lassezuengel/OpenMicroQuad-S1/assets/stackup.png

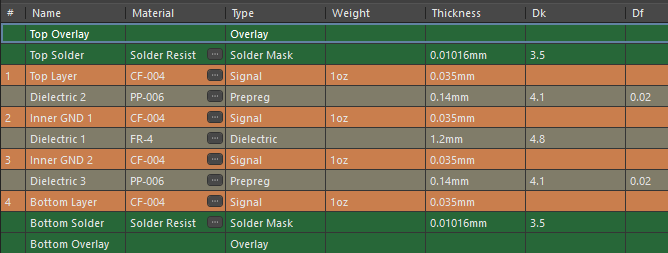
assets/stackup.png
