lassezuengel/OpenMicroQuad-S1/mcad/Drone 1S.step

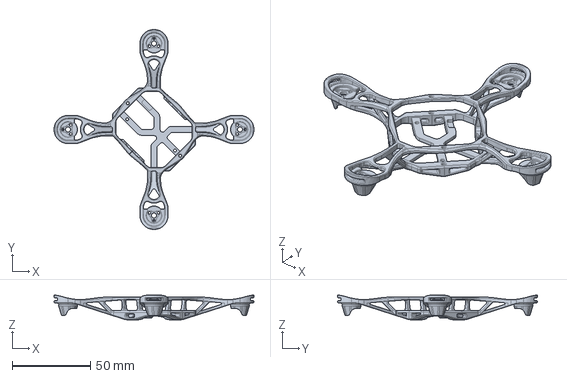
[picture p10: CAD file, 2026-10-10]
mcad/Drone 1S.step
128.0 x 128.0 x 15.8 mm
