lassezuengel/OpenMicroQuad-S1/ecad/ESC-FPV/ESC-FPV/ESC-FPV.pdf

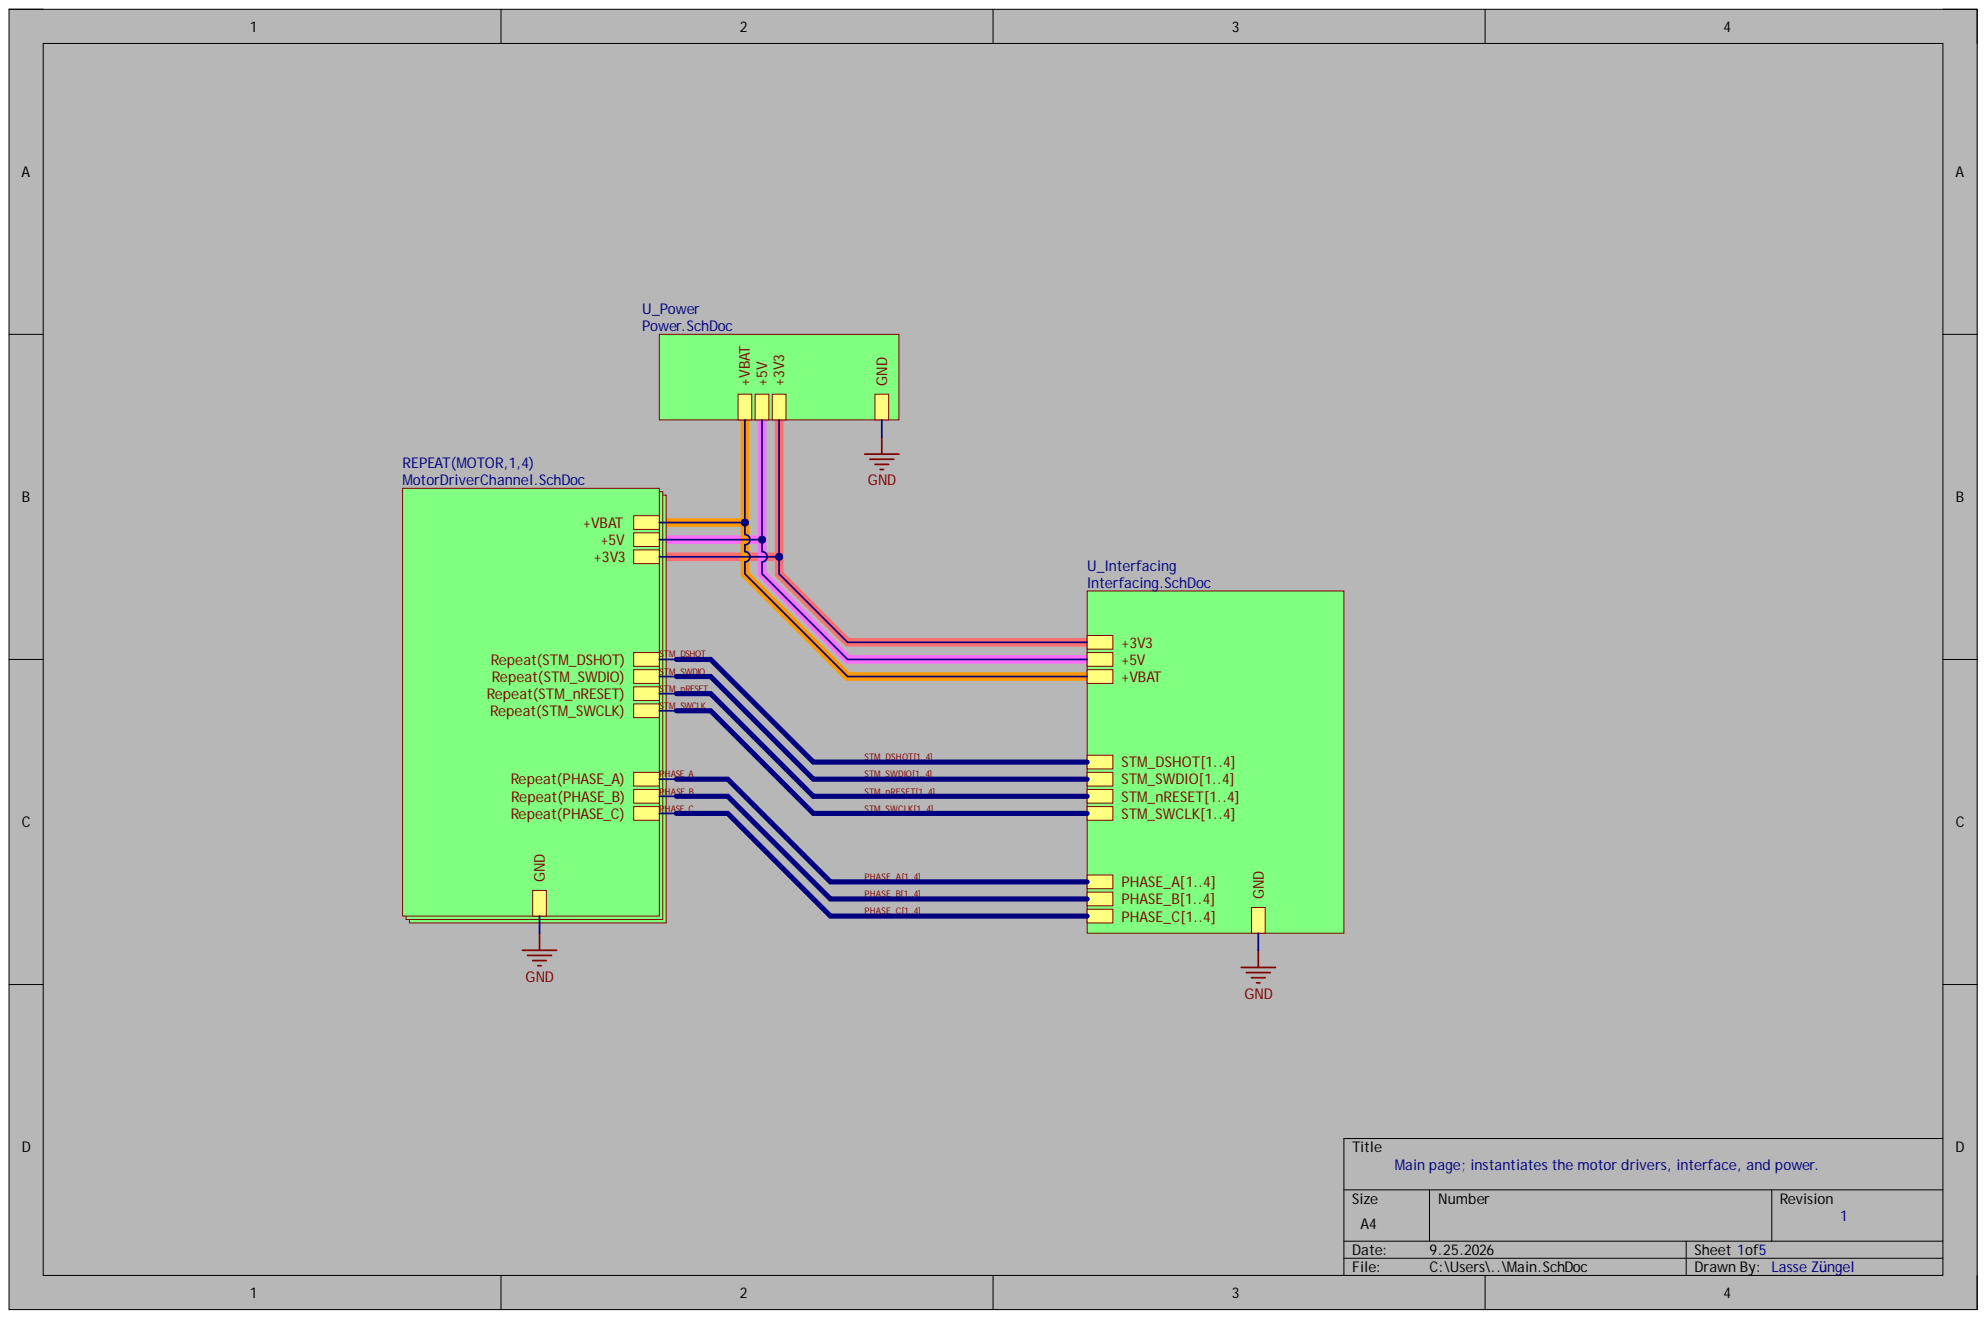
[picture p11: page 1]

Title
Main page; instantiates the motor drivers, interface, and power.

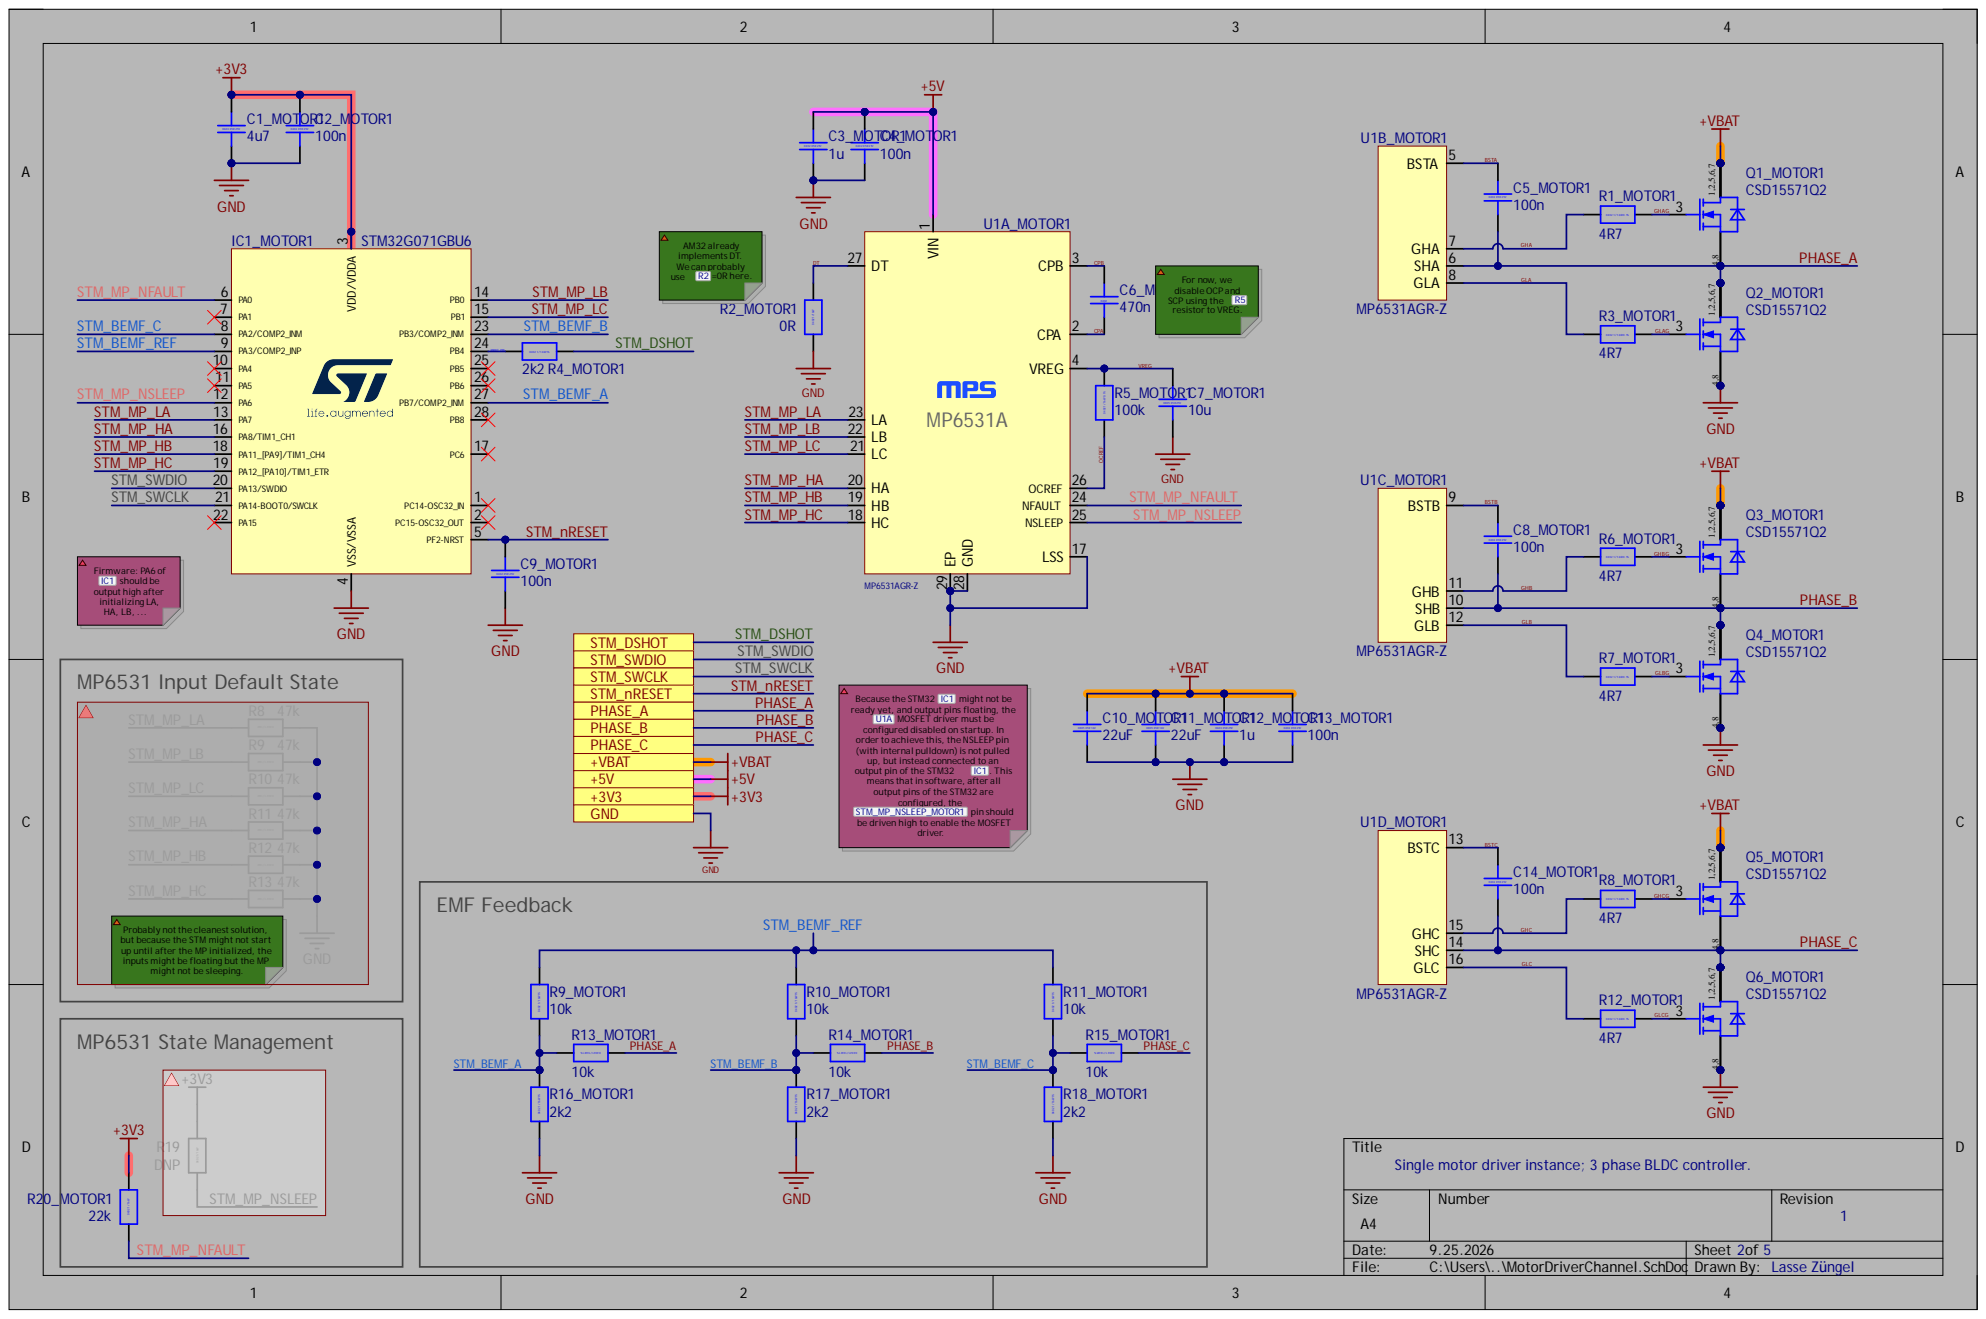
[picture p12: page 2]

VDD/VDDA 3 VSS/VSSA 4

Because the STM32 IC1 might not be
ready yet, and output pins floating, the

U1A MOSFET driver must be
configured disabled on startup. In
order to achieve this, the NSLEEP pin
(with internal pulldown) is not pulled
up, but instead connected to an
means thatin software, after all
output pins of the STM32 are
configured, the

STM_MP_NSLEEP_MOTOR1 pin should
be driven high to enable the MOSFET

Probably notthe cleanest solution,
but because the STM might not start
up until after the MP initialized, the
inputs might be floating but the MP

might not be sleeping.

Title
Single motor driver instance; 3 phase BLDC controller.

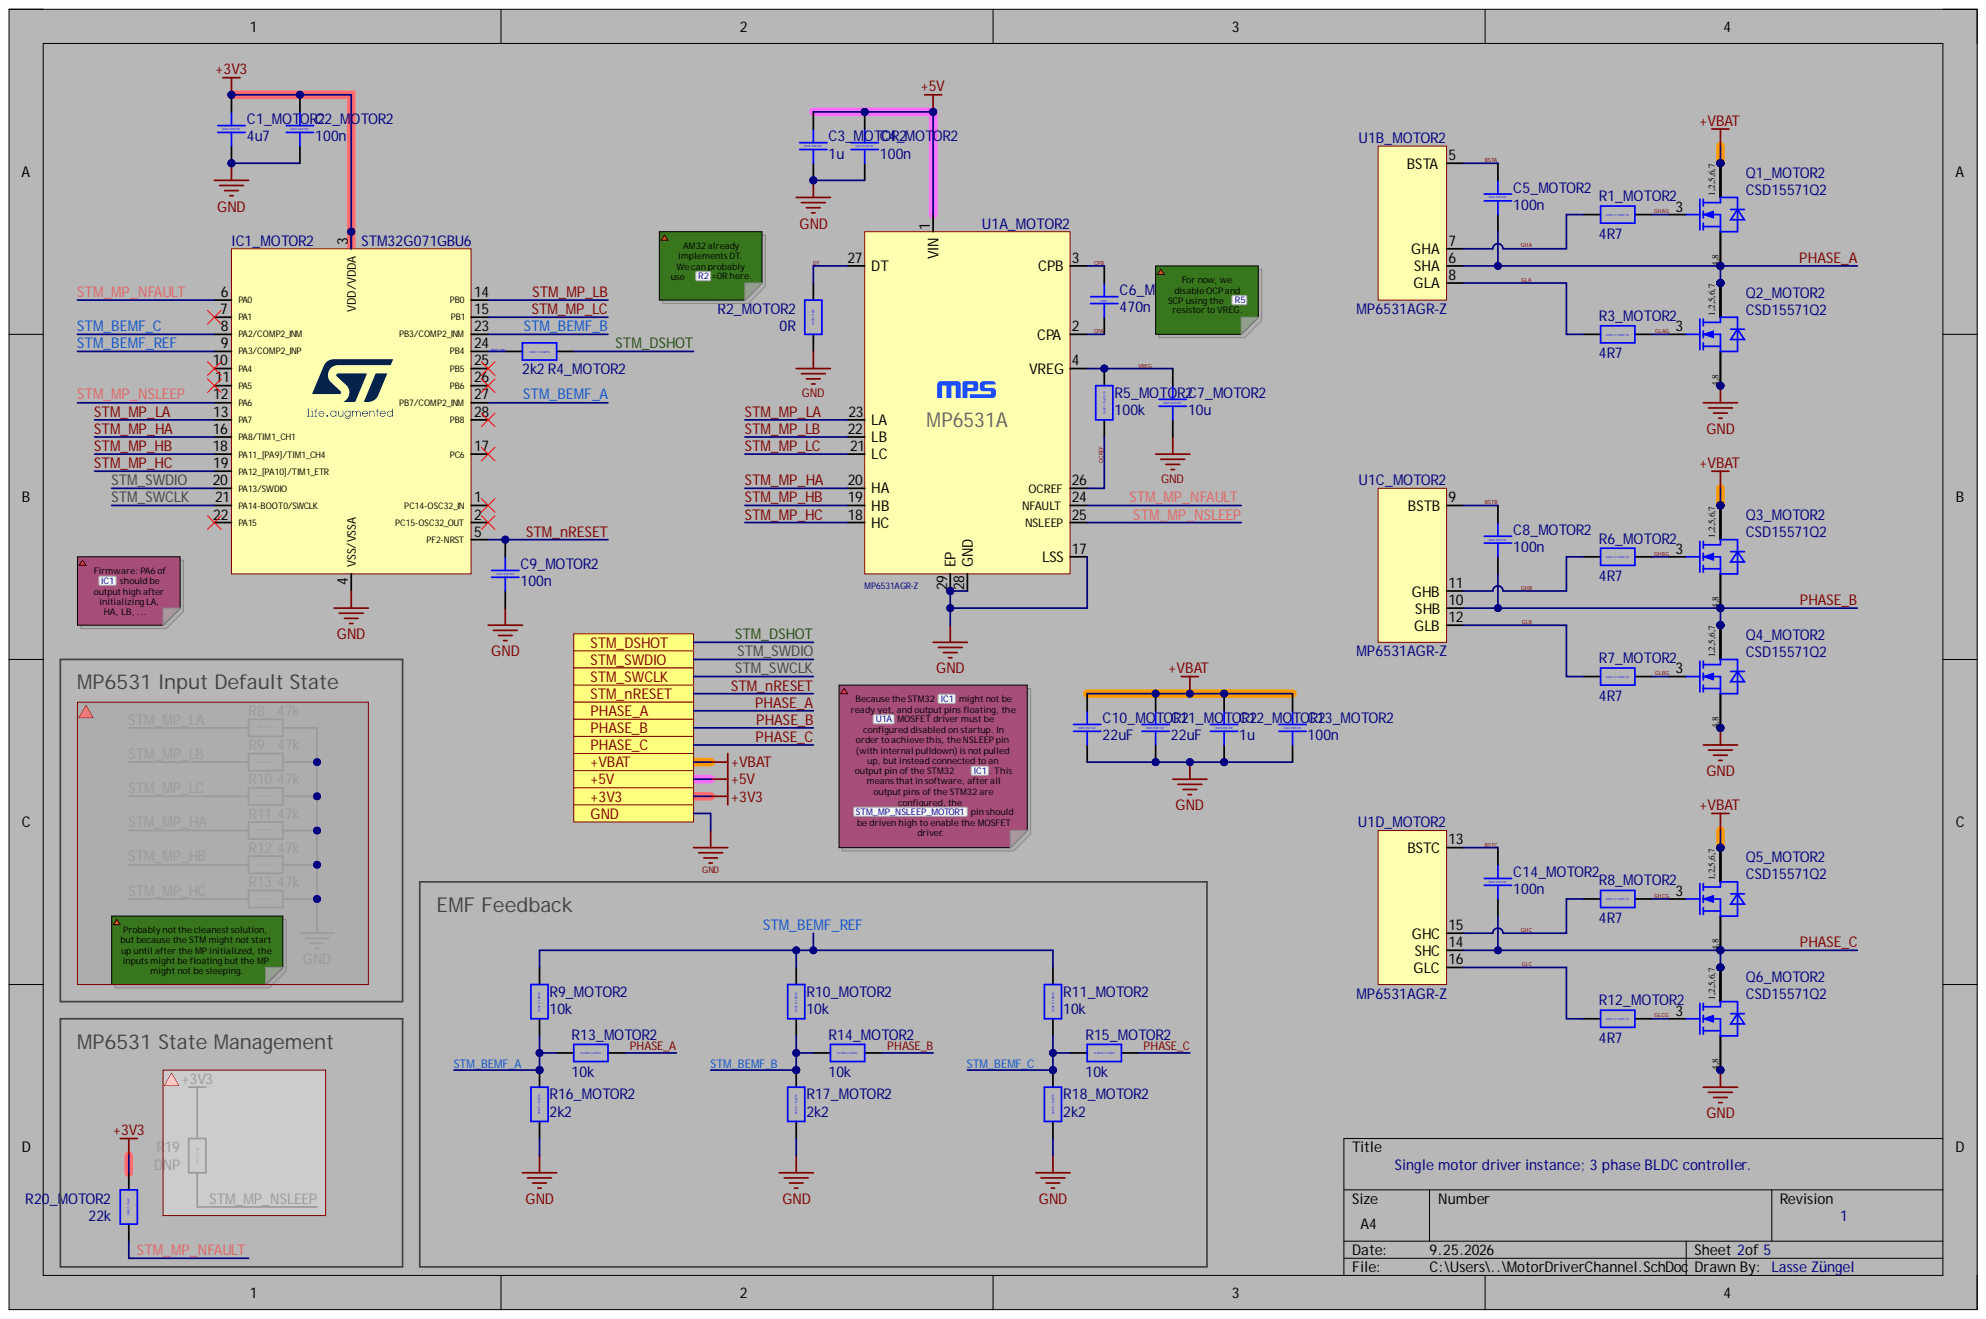
[picture p13: page 3]

VDD/VDDA 3 VSS/VSSA 4

Because the STM32 IC1 might not be
ready yet, and output pins floating, the

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

STM_MP_NSLEEP_MOTOR1 pin should
be driven high to enable the MOSFET

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

might not be sleeping.

Title
Single motor driver instance; 3 phase BLDC controller.

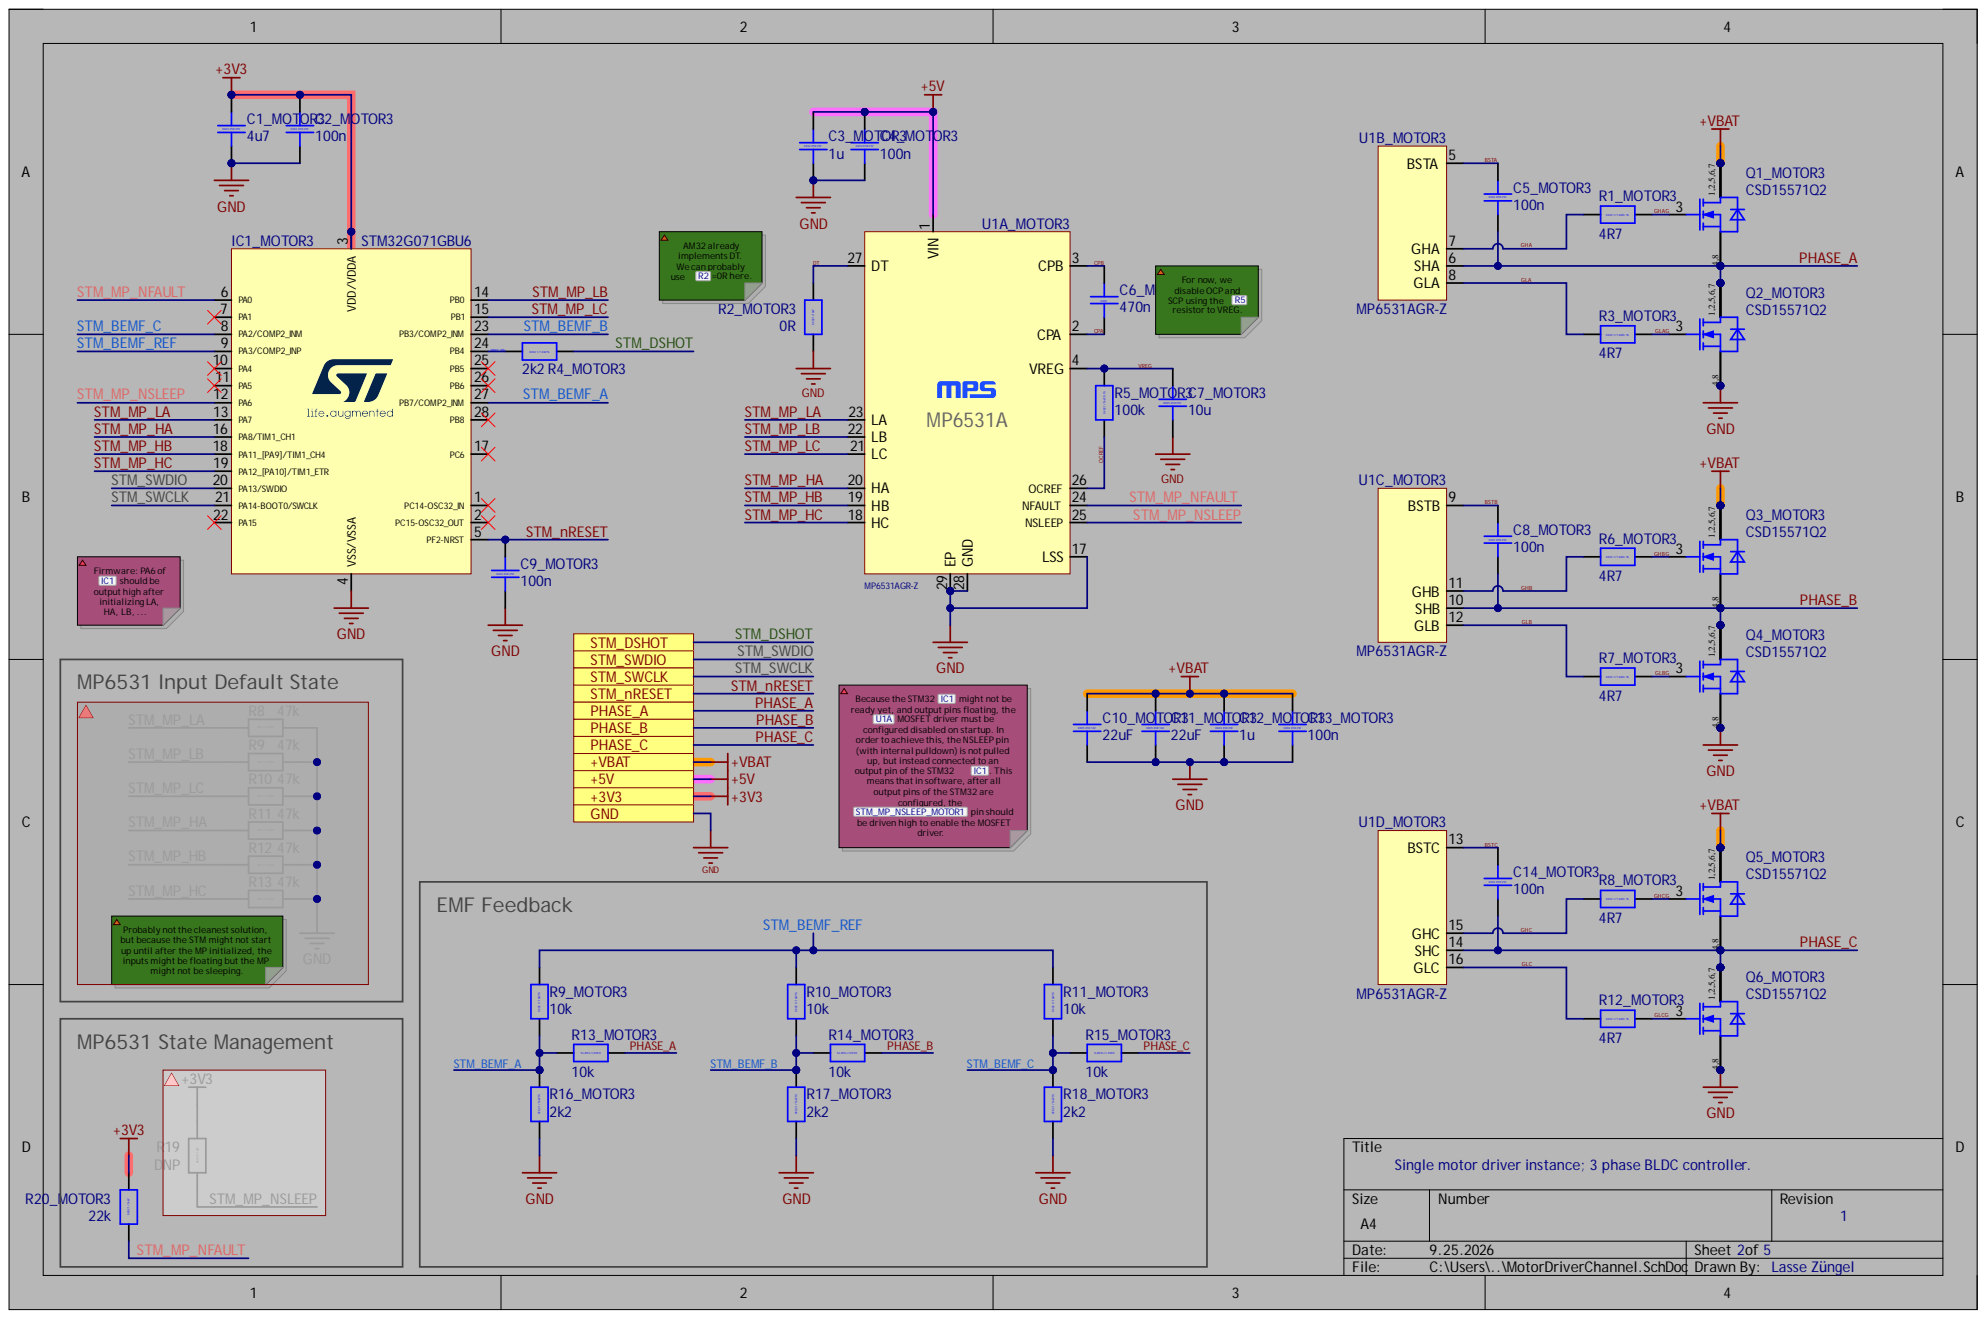
[picture p14: page 4]

VDD/VDDA 3 VSS/VSSA 4

Because the STM32 IC1 might not be
ready yet, and output pins floating, the

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

STM_MP_NSLEEP_MOTOR1 pin should
be driven high to enable the MOSFET

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

might not be sleeping.

Title
Single motor driver instance; 3 phase BLDC controller.

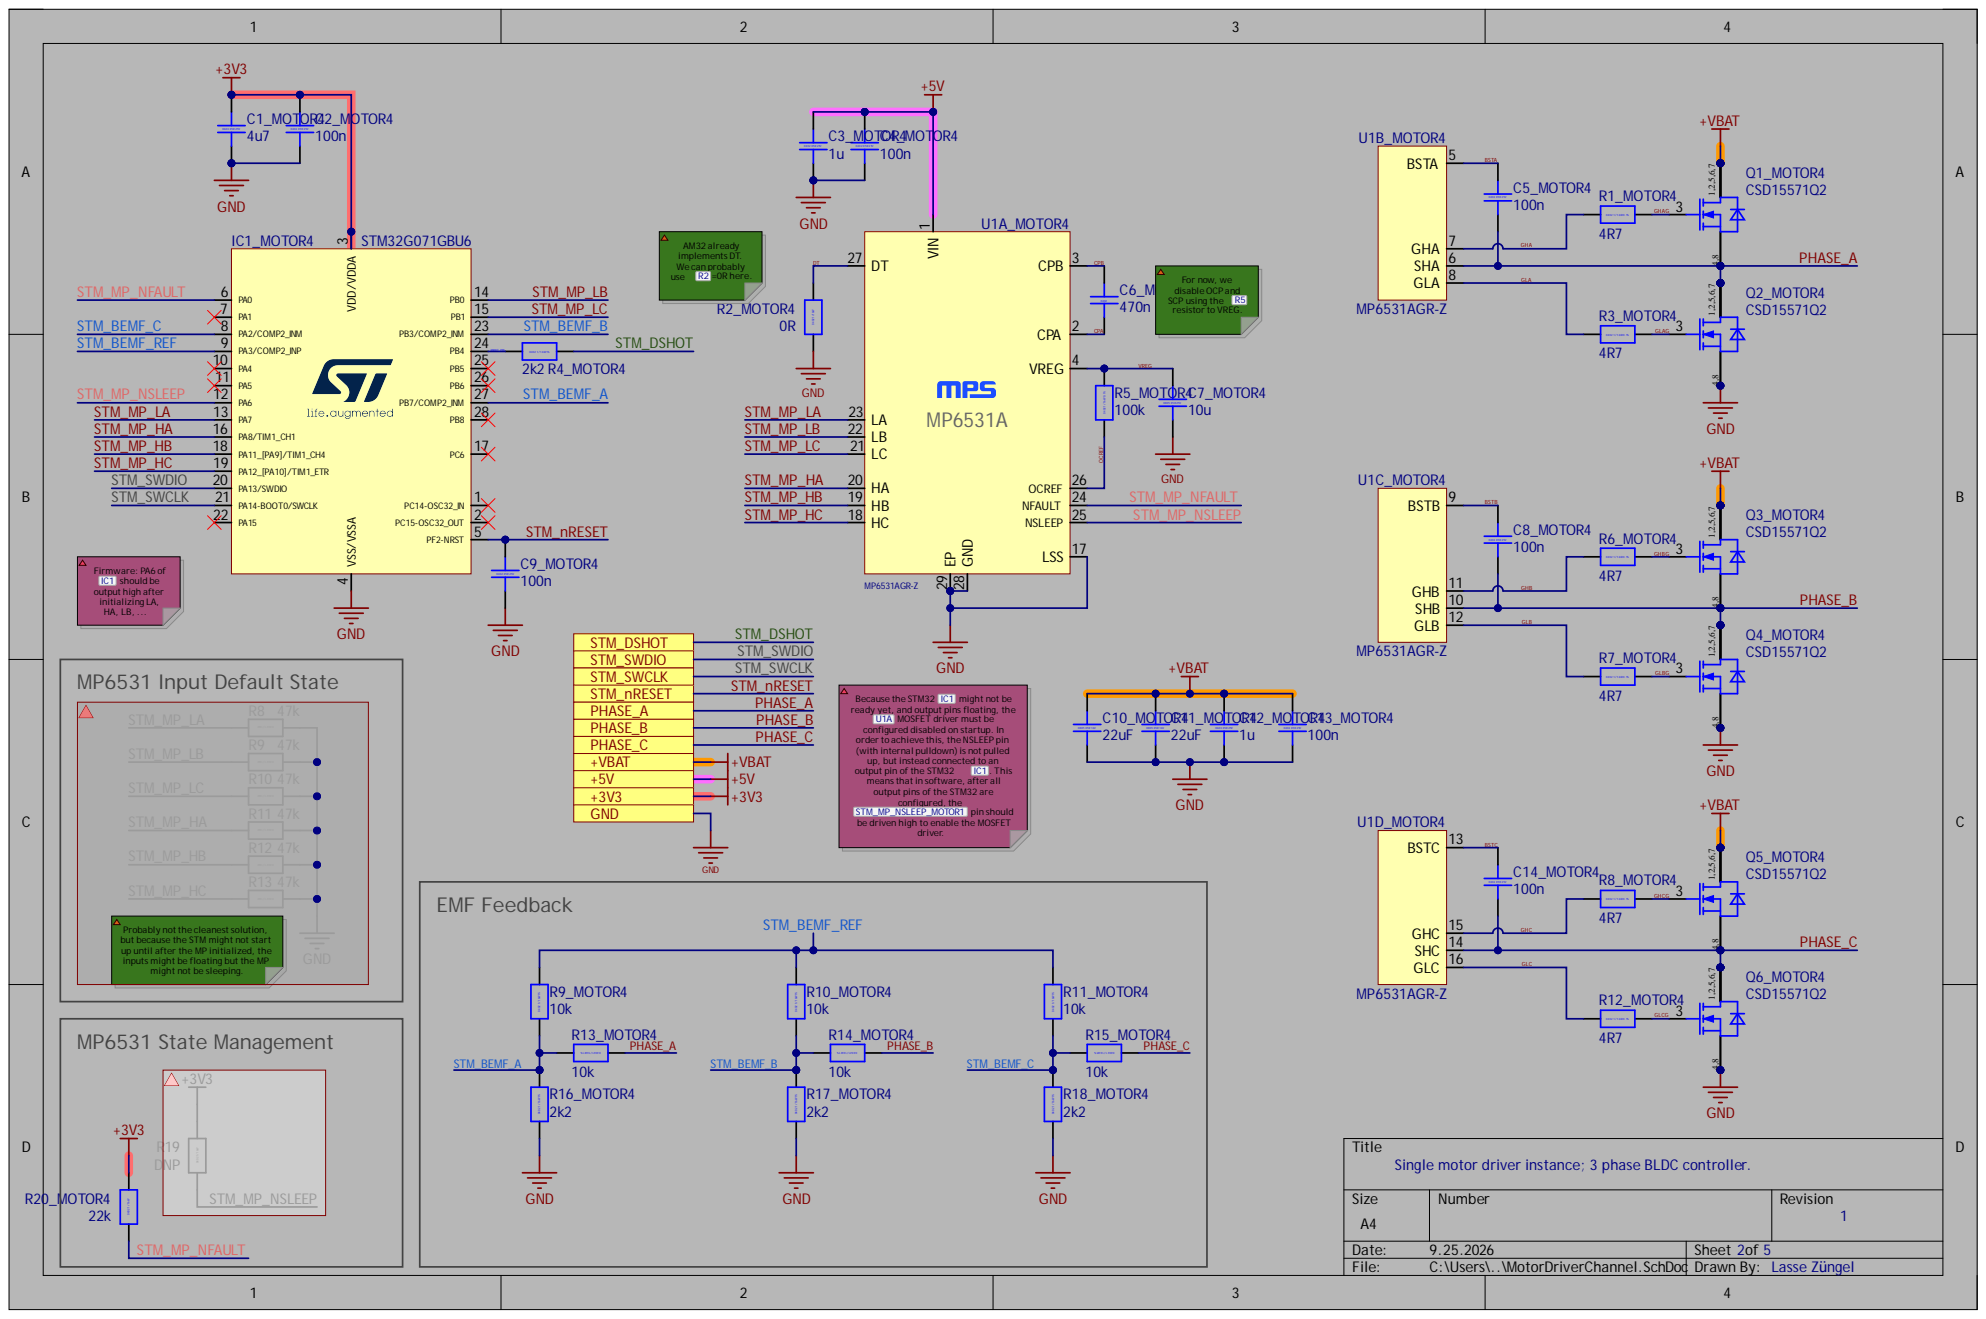
[picture p15: page 5]

VDD/VDDA 3 VSS/VSSA 4

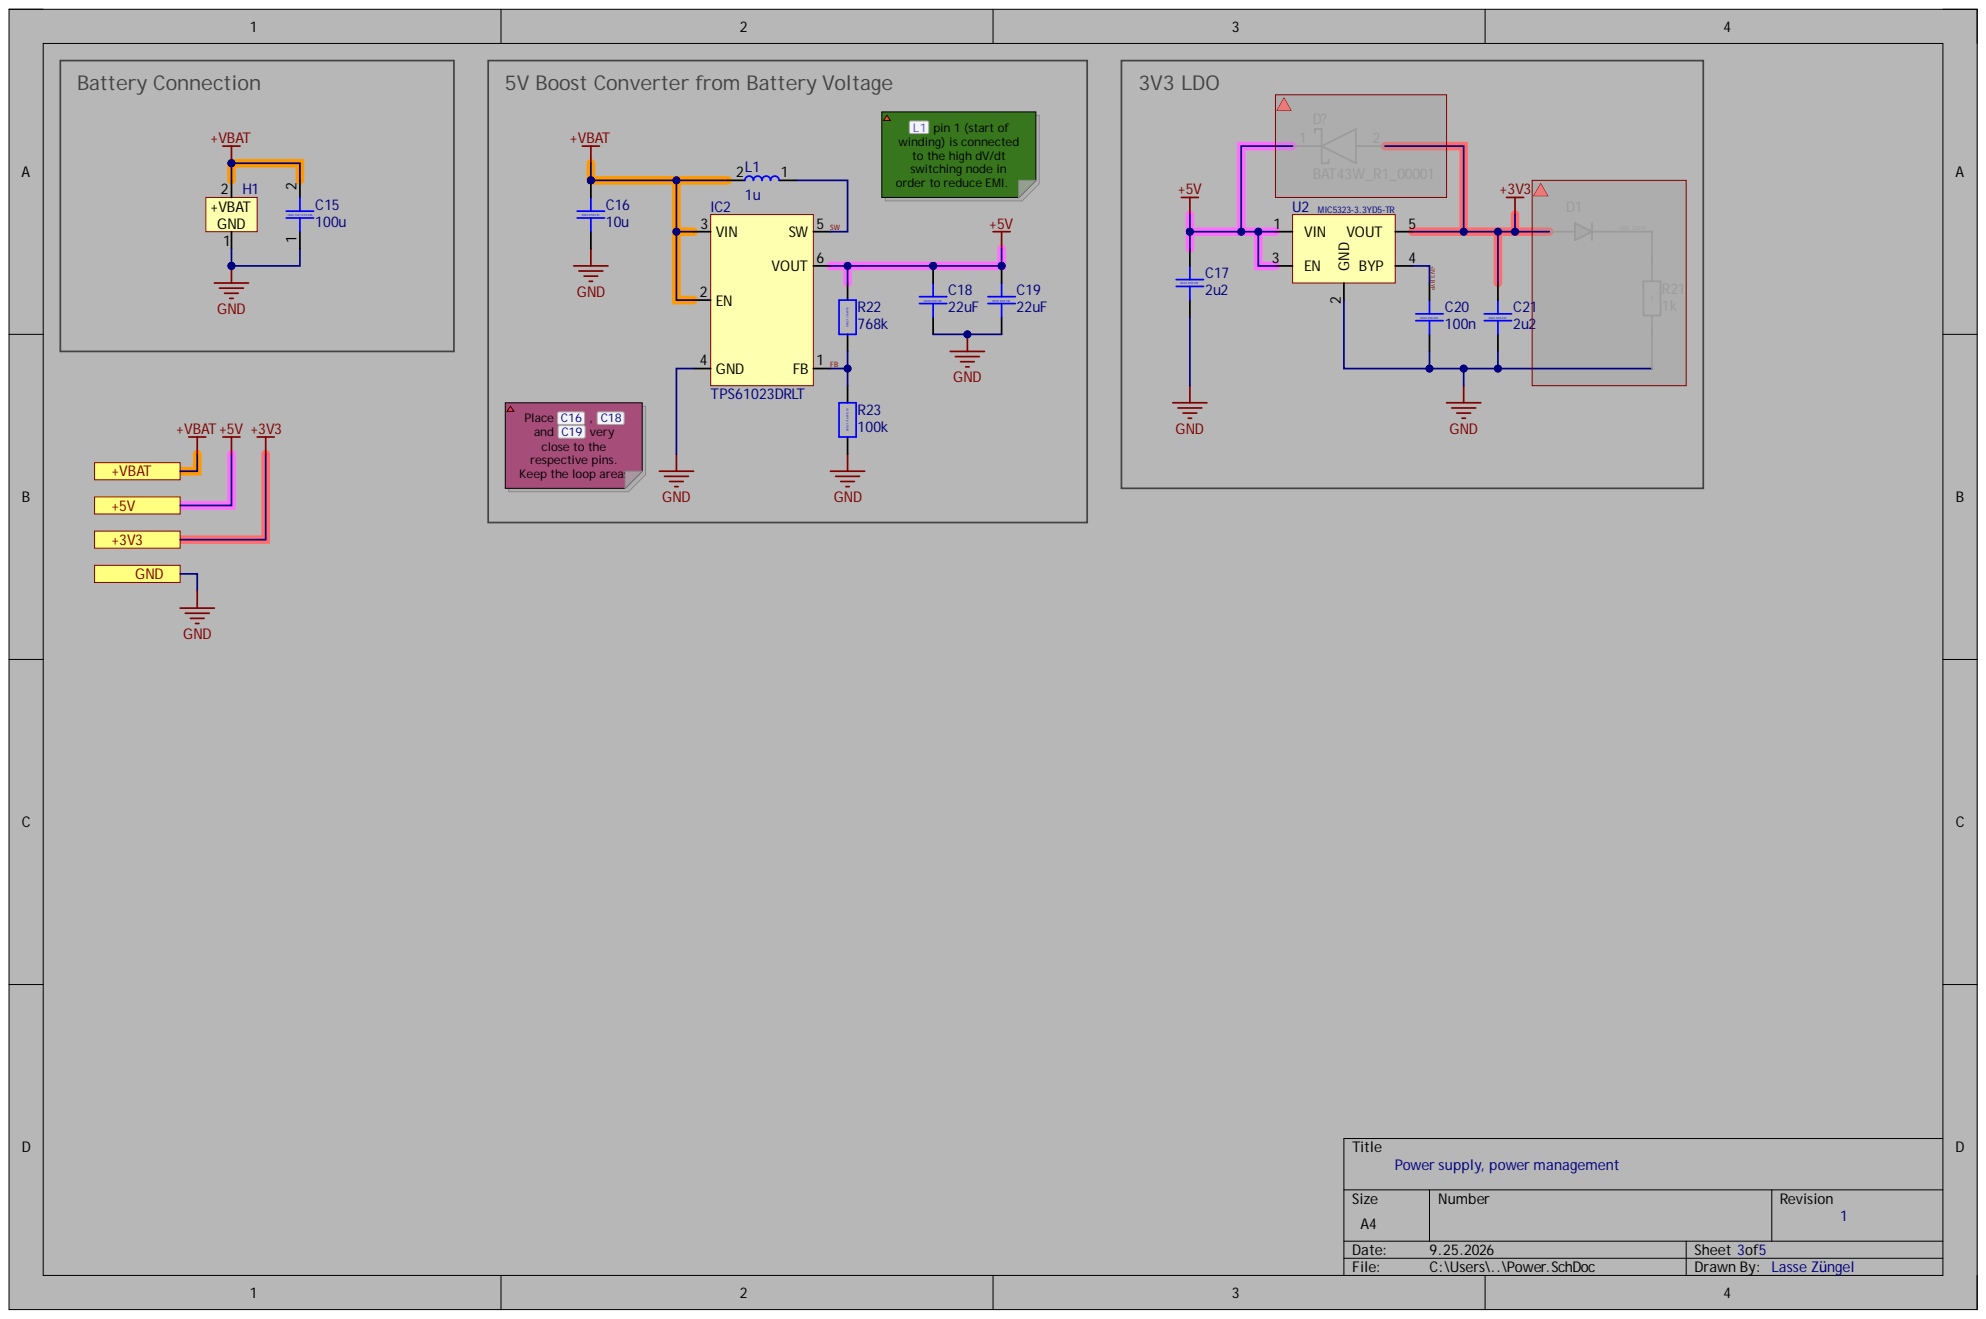
[picture p16: page 6]

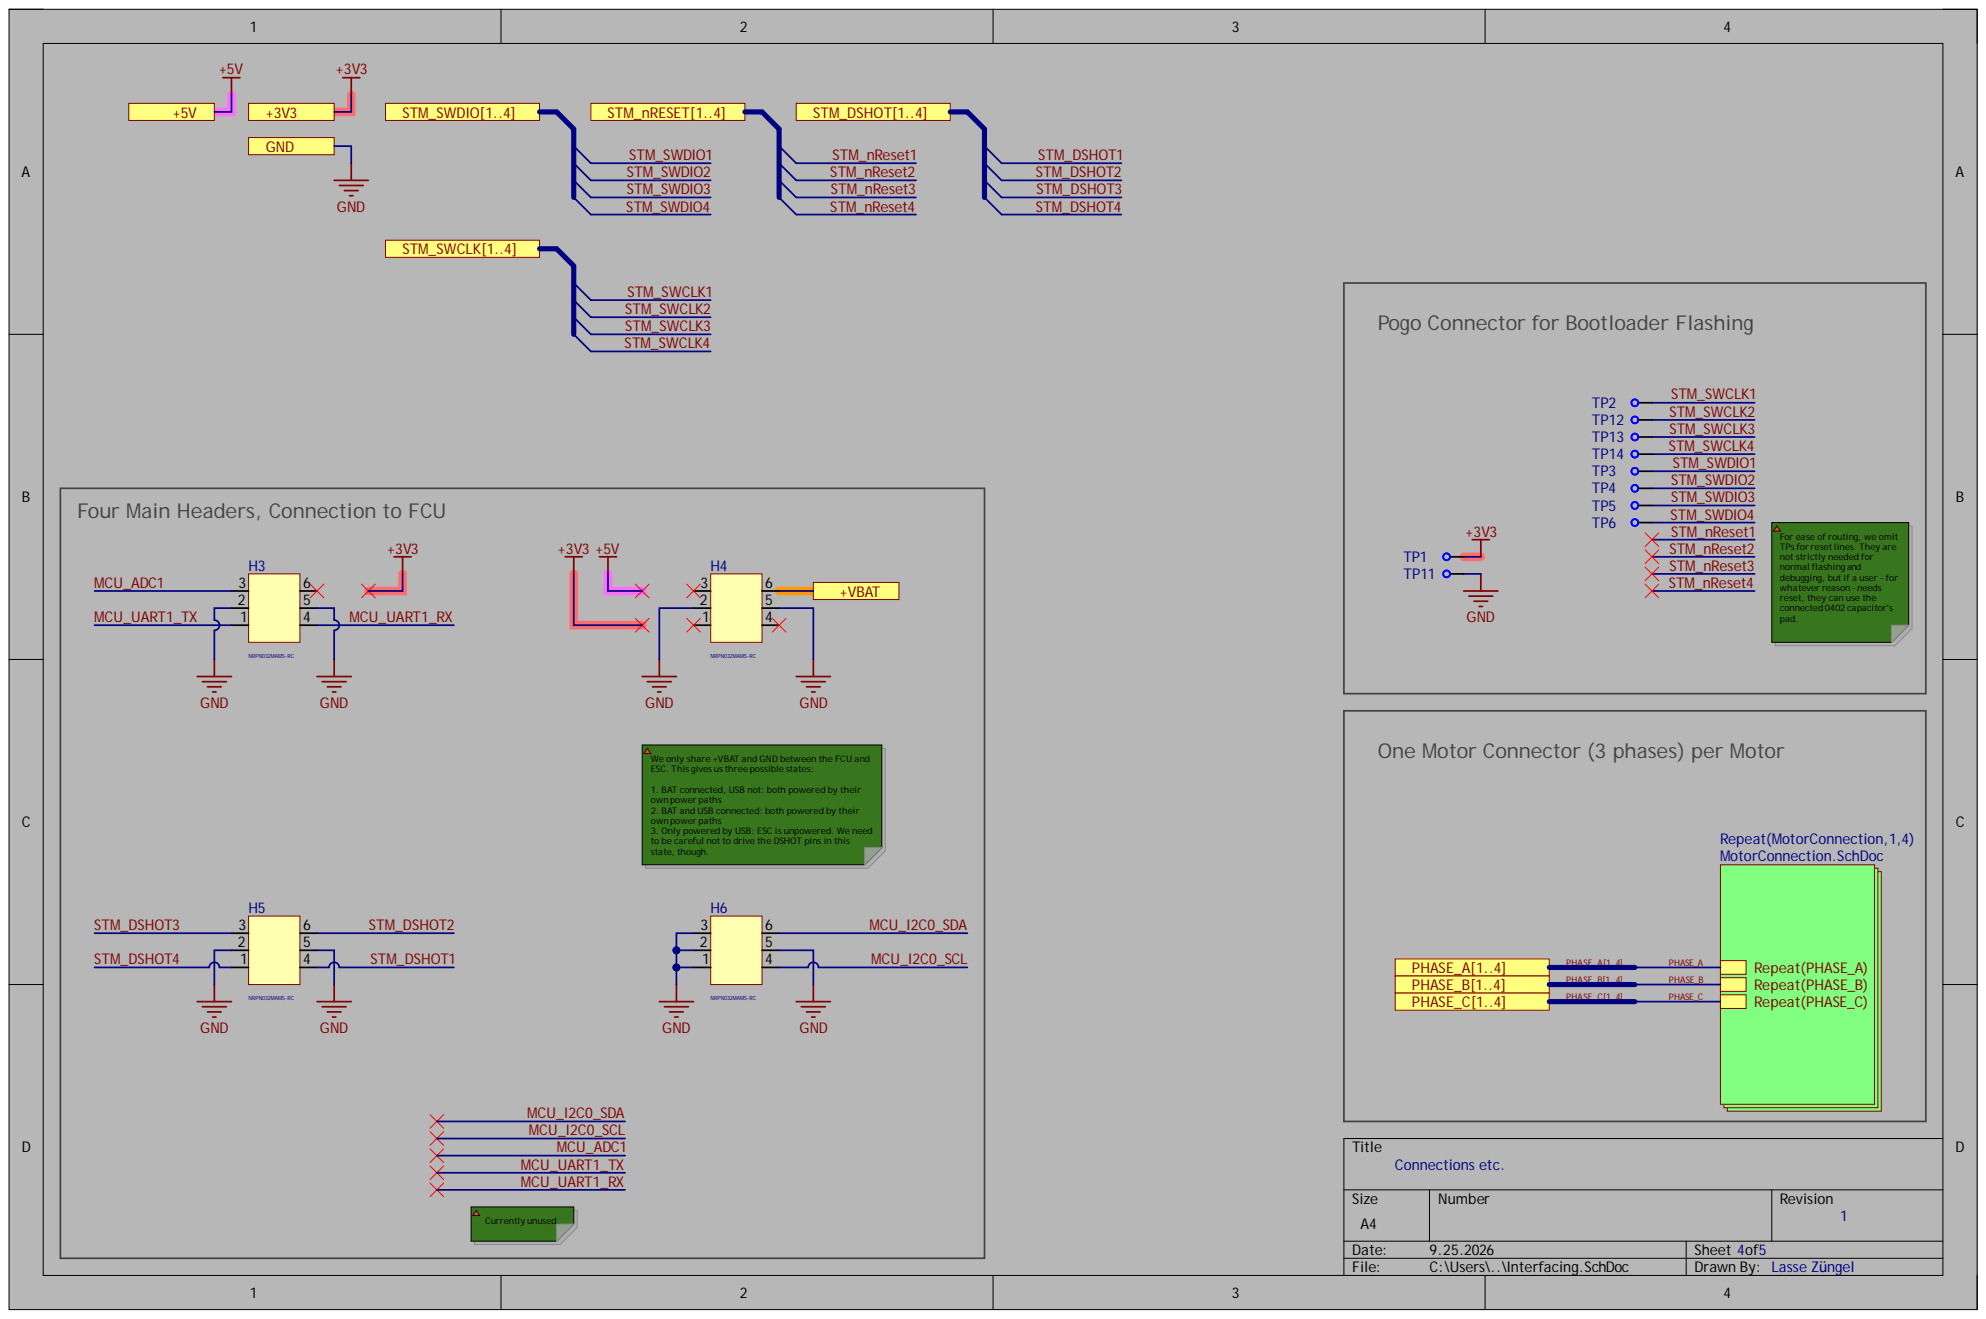
[picture p17: page 7]

Pogo Connector for Bootloader Flashing

Four Main Headers, Connection to FCU

For ease of routing, we omit
TPs for resetlines. They are
not strictly needed for
normal flashing and
debugging, but if a user - for
whatever reason - needs
reset, they can use the
connected 0402 capacitor's
pad.

We only share +VBAT and GND between the FCU and
ESC. This gives us three possible states:

One Motor Connector (3 phases) per Motor

1. BAT connected, USB not: both powered by their
own power paths
2. BAT and USB connected: both powered by their
3. Only powered by USB: ESC is unpowered. We need
to be careful not to drive the DSHOT pins in this
state, though.

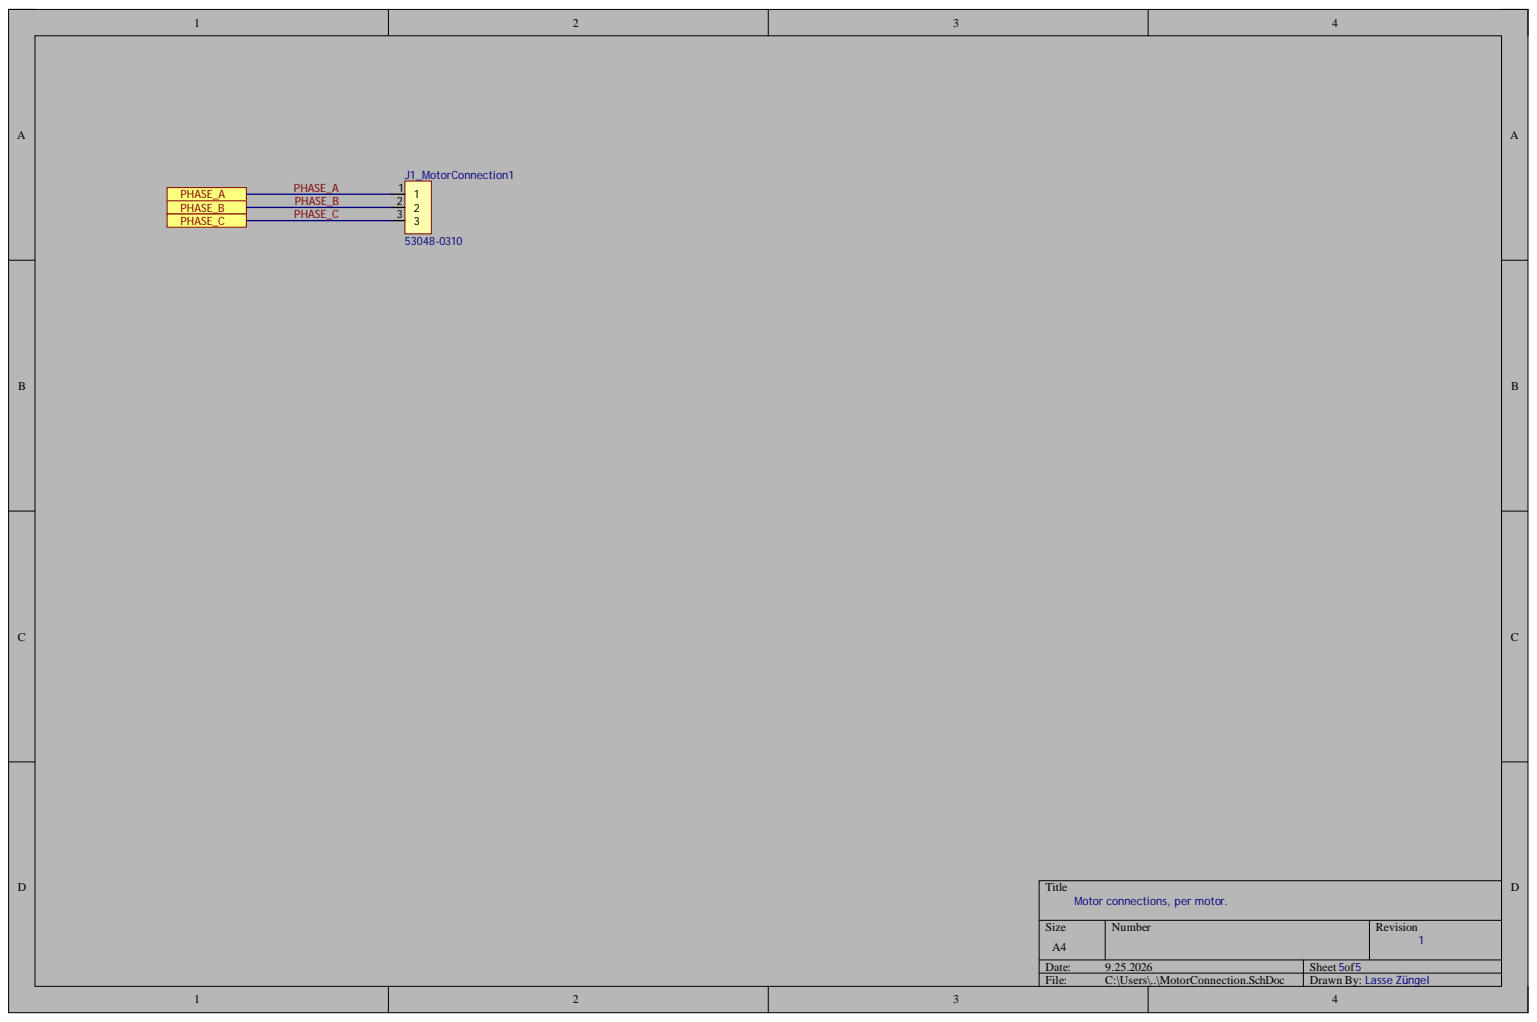
[picture p18: page 8]

Title
Motor connections, per motor.

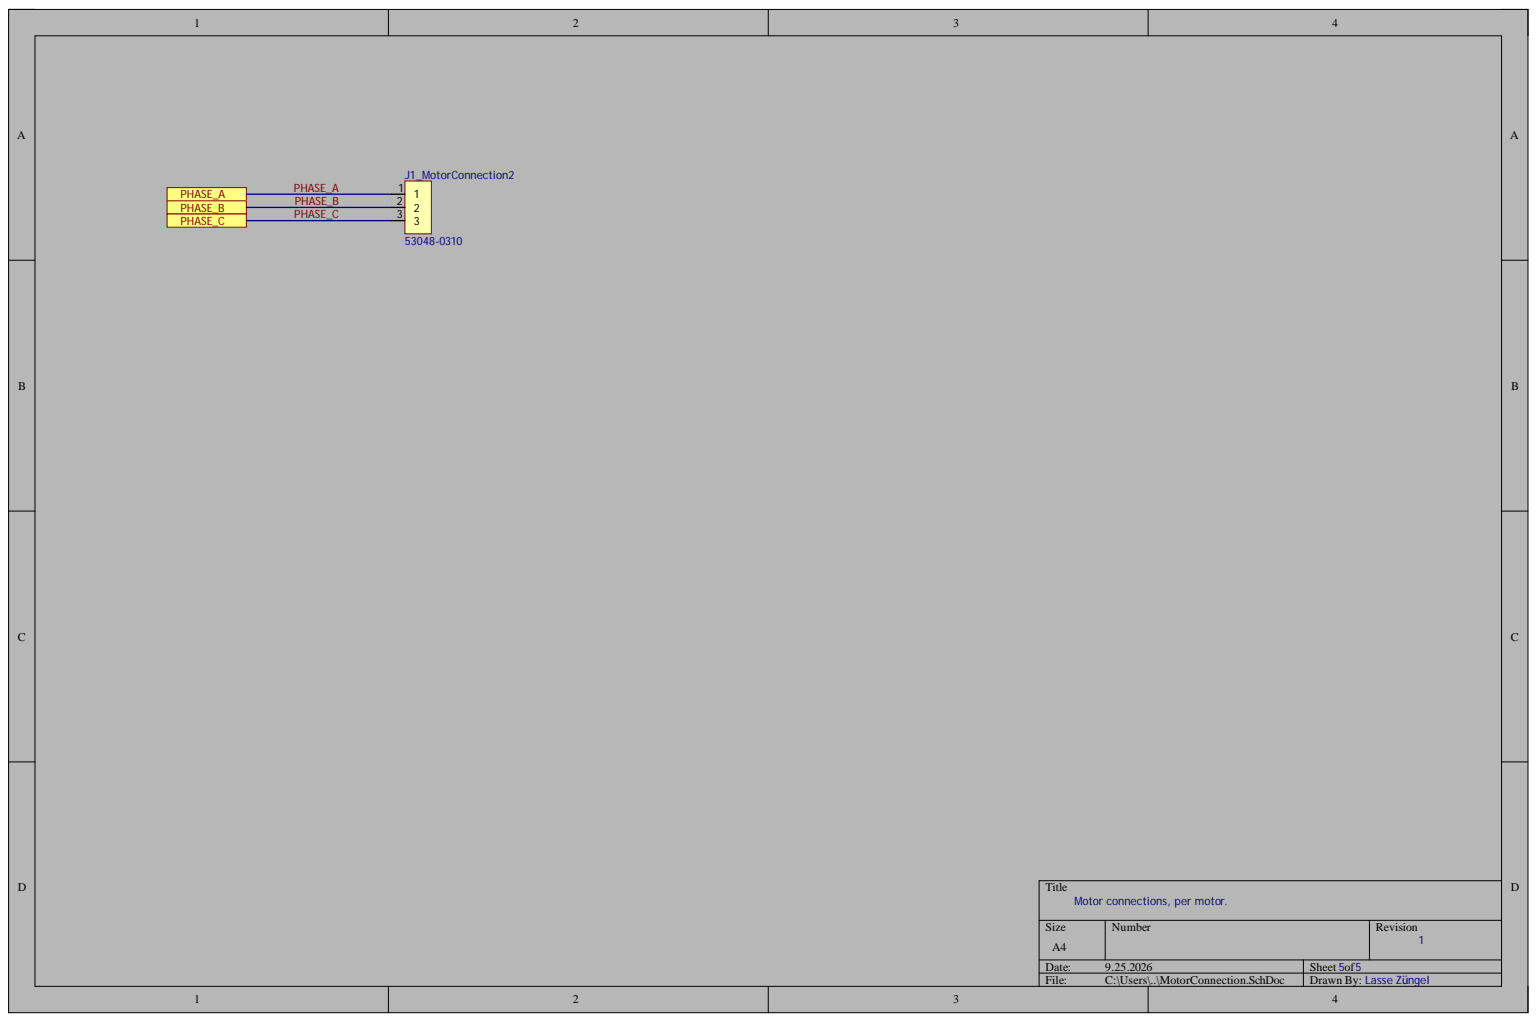
[picture p19: page 9]

Title
Motor connections, per motor.

Title
Motor connections, per motor.

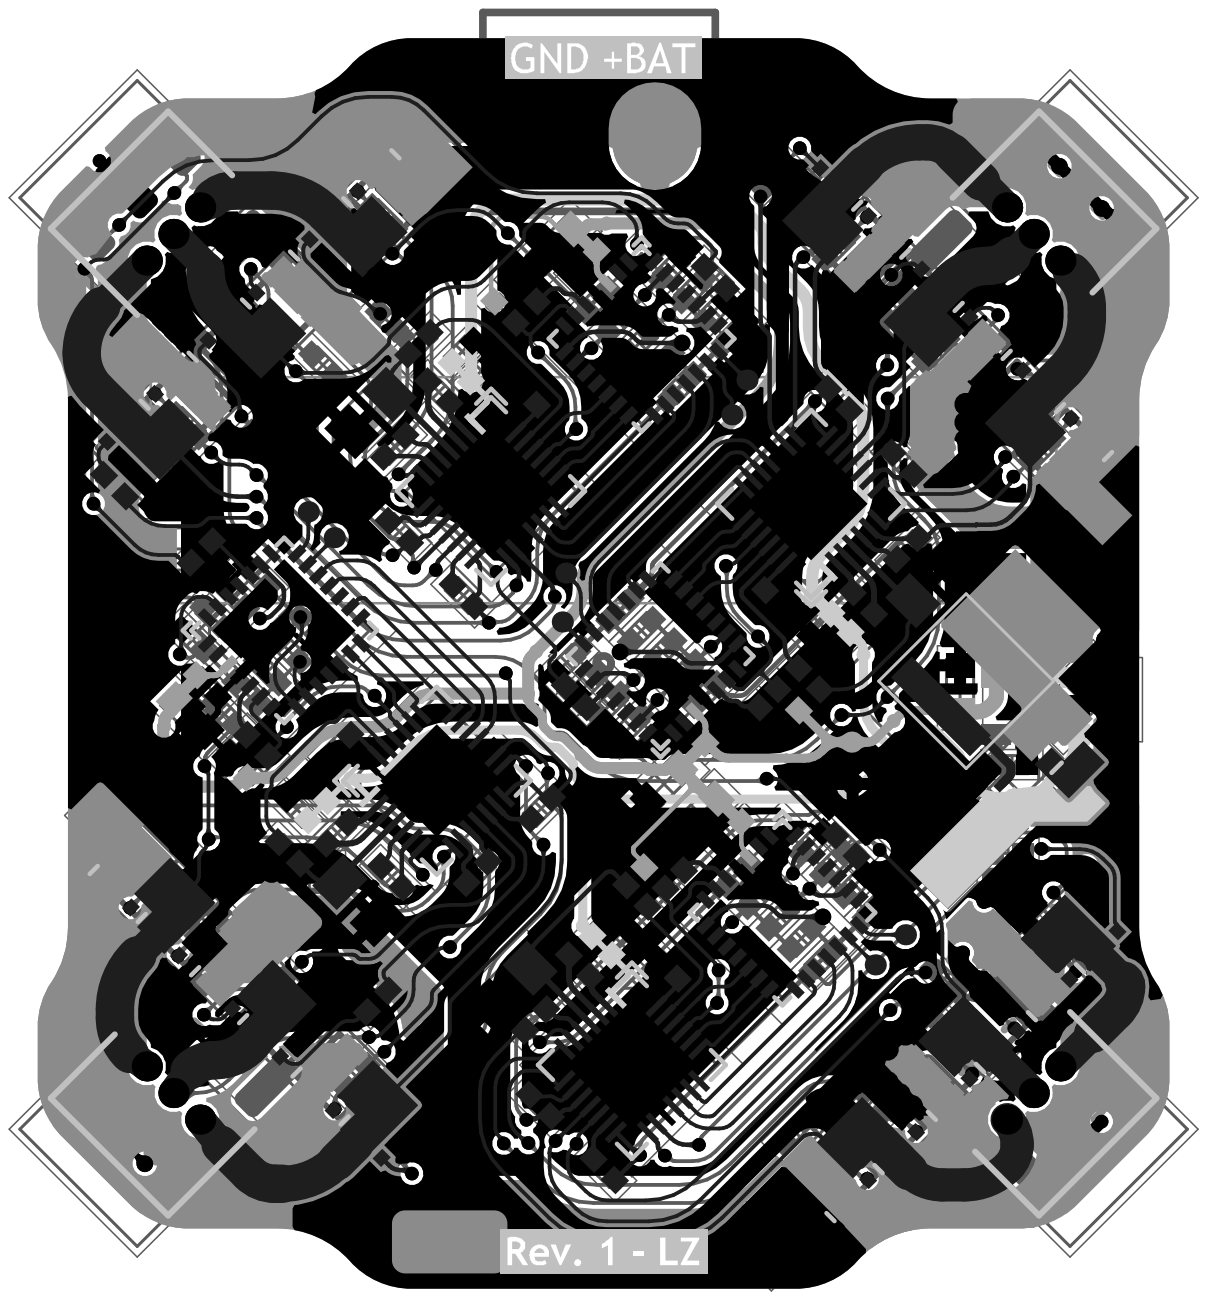
[picture p20: page 12]
