lassezuengel/OpenMicroQuad-S1/ecad/RP2040-FPV/RP2040-FPV/RP2040-FPV.pdf

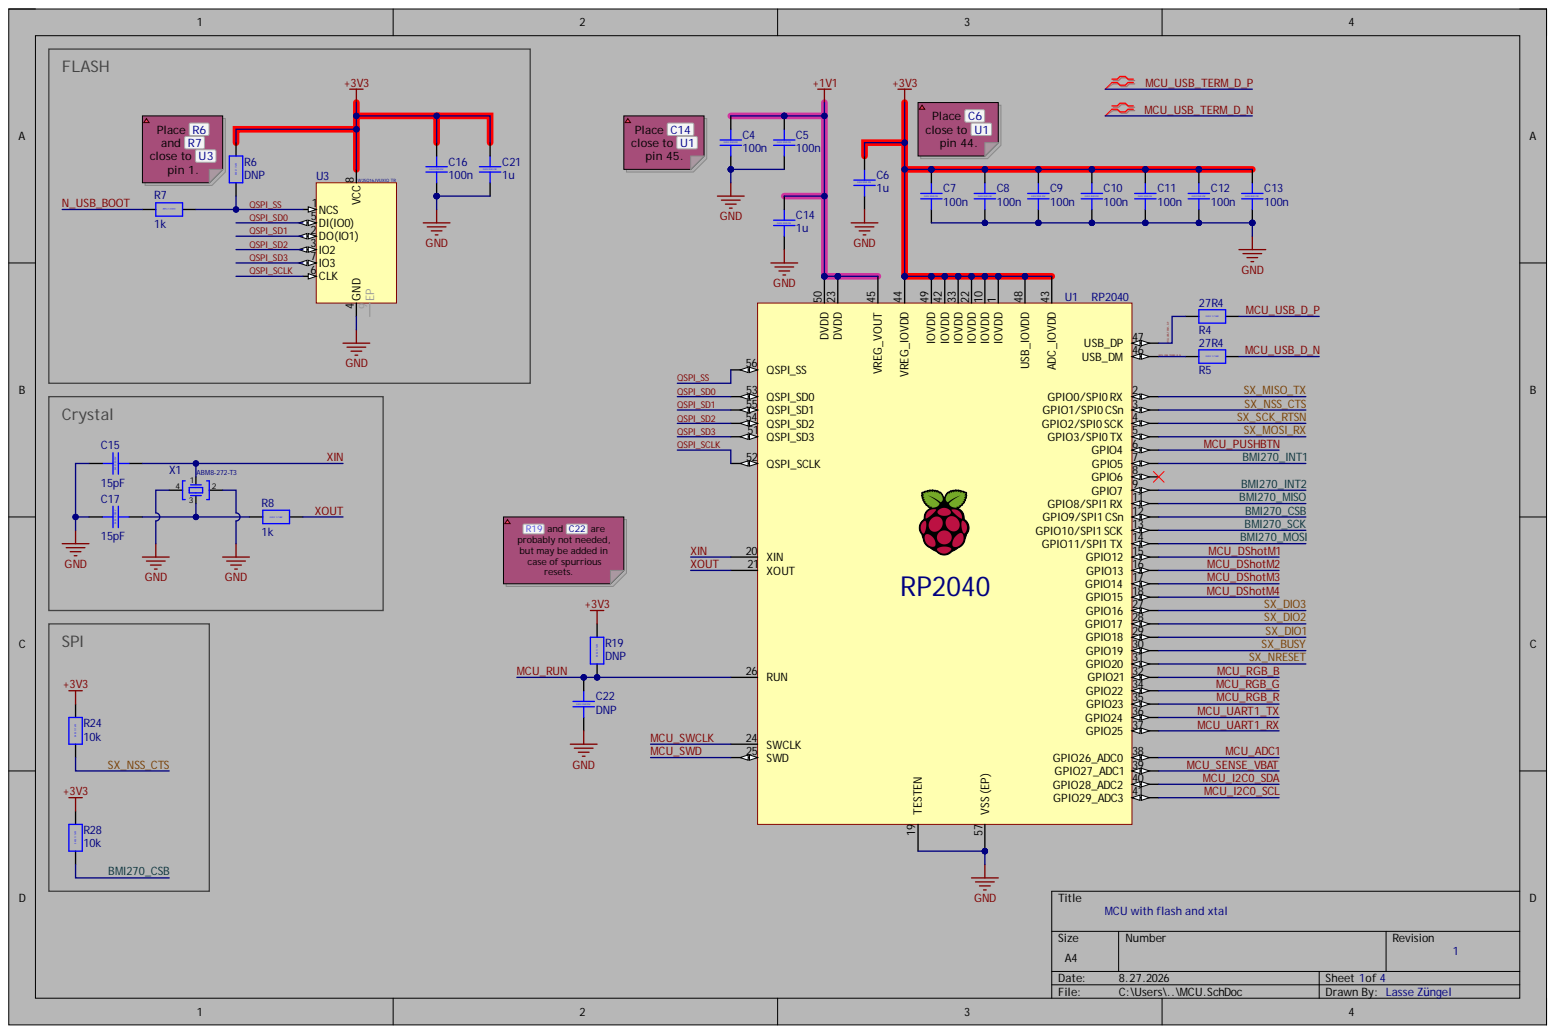
[picture p21: page 1]

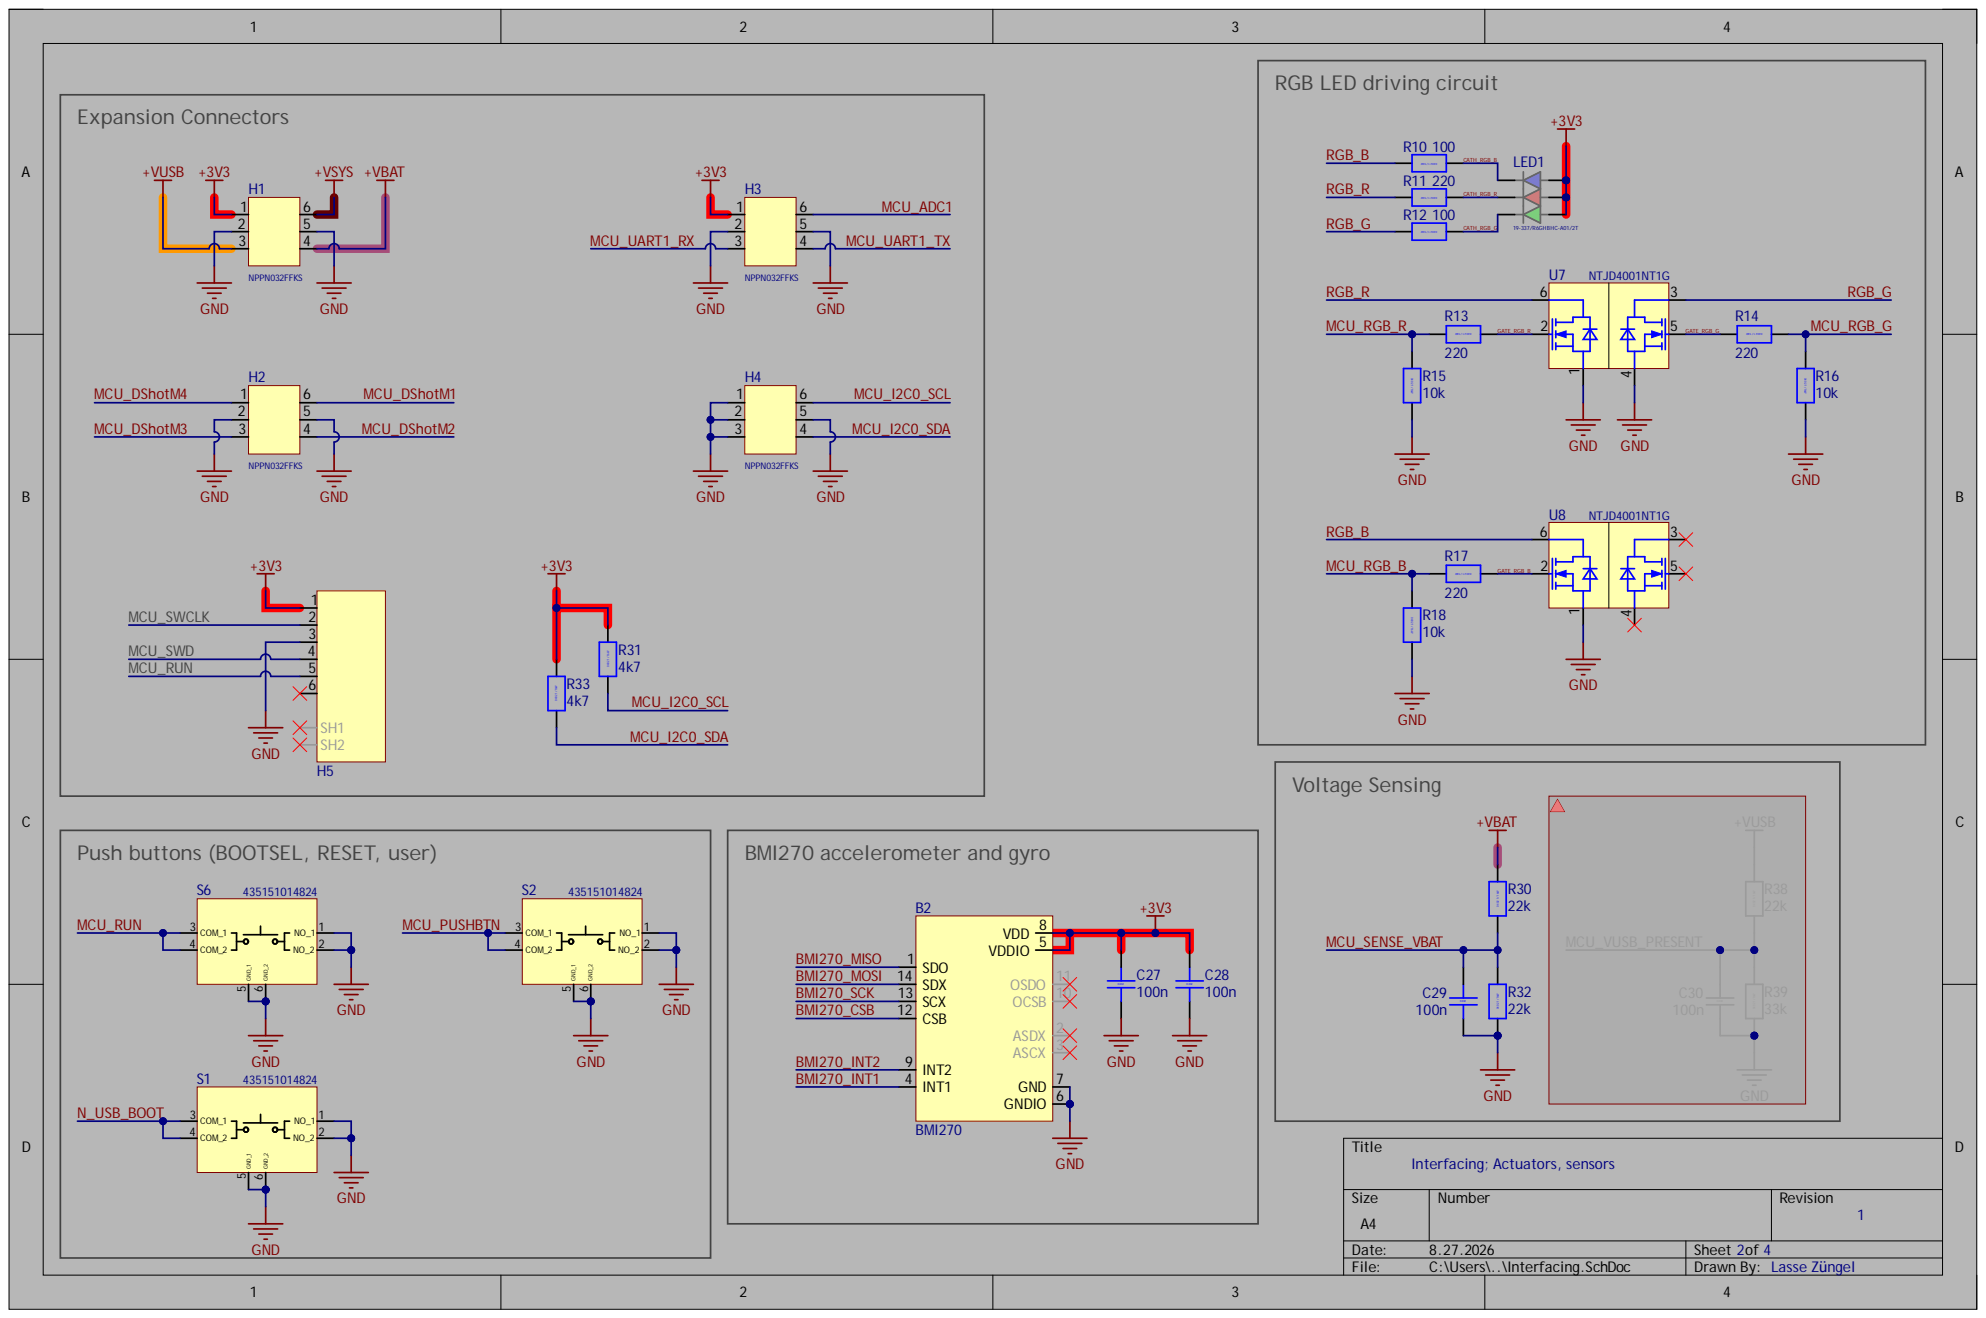
[picture p22: page 2]

RGB LED driving circuit

Push buttons (BOOTSEL, RESET, user)

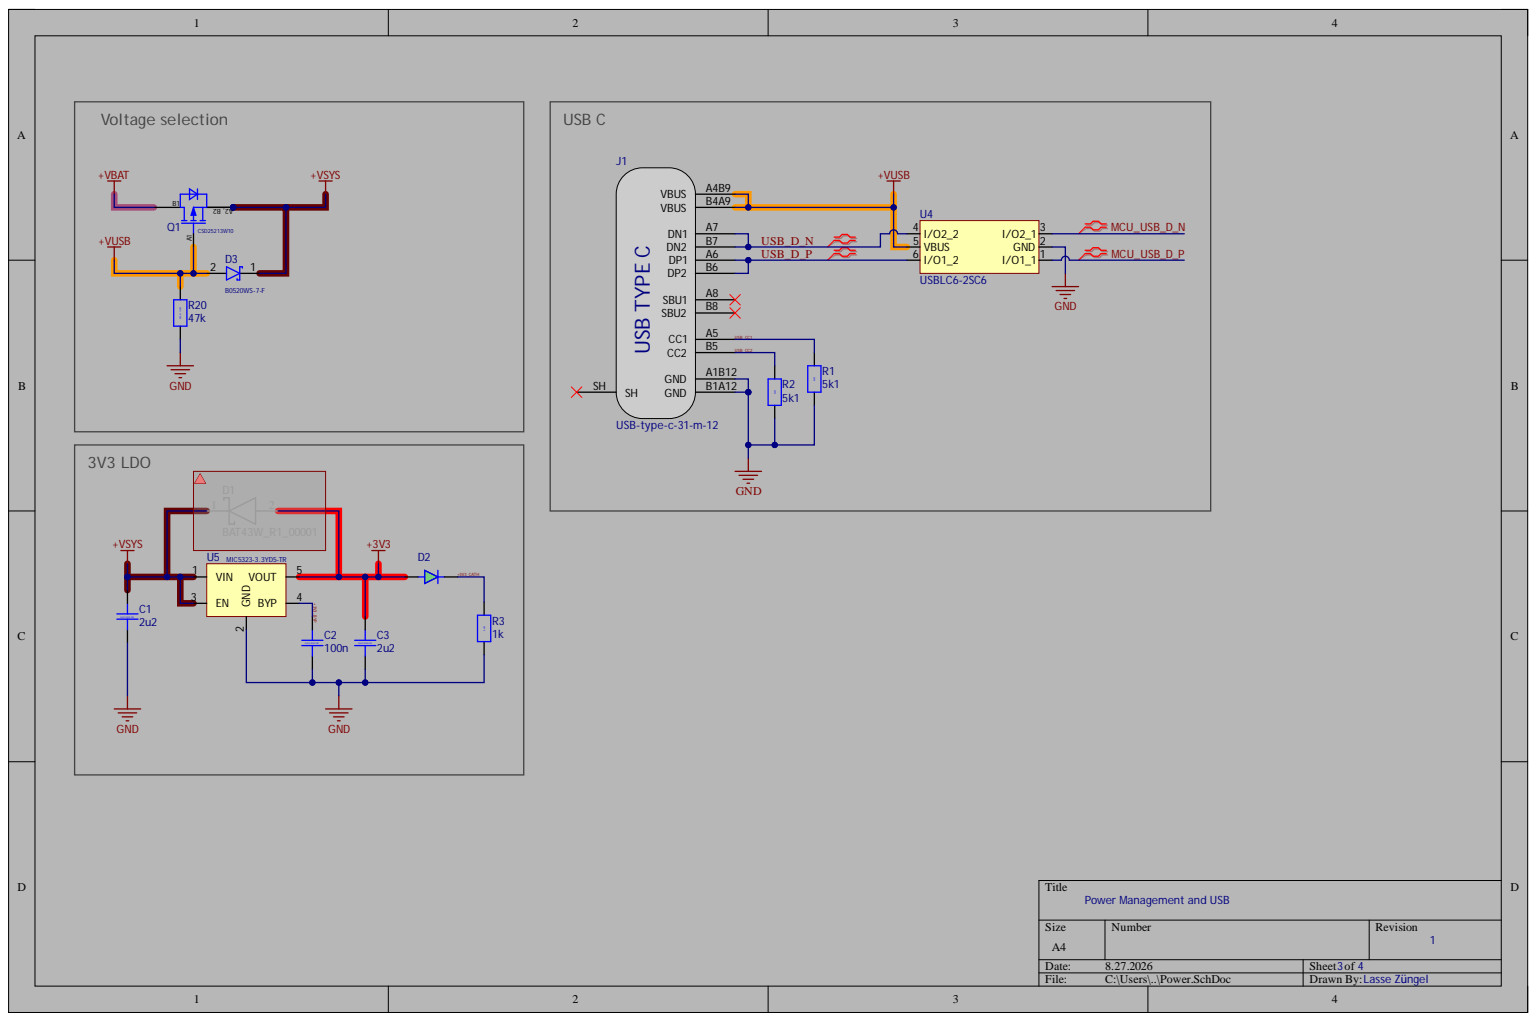
[picture p23: page 3]

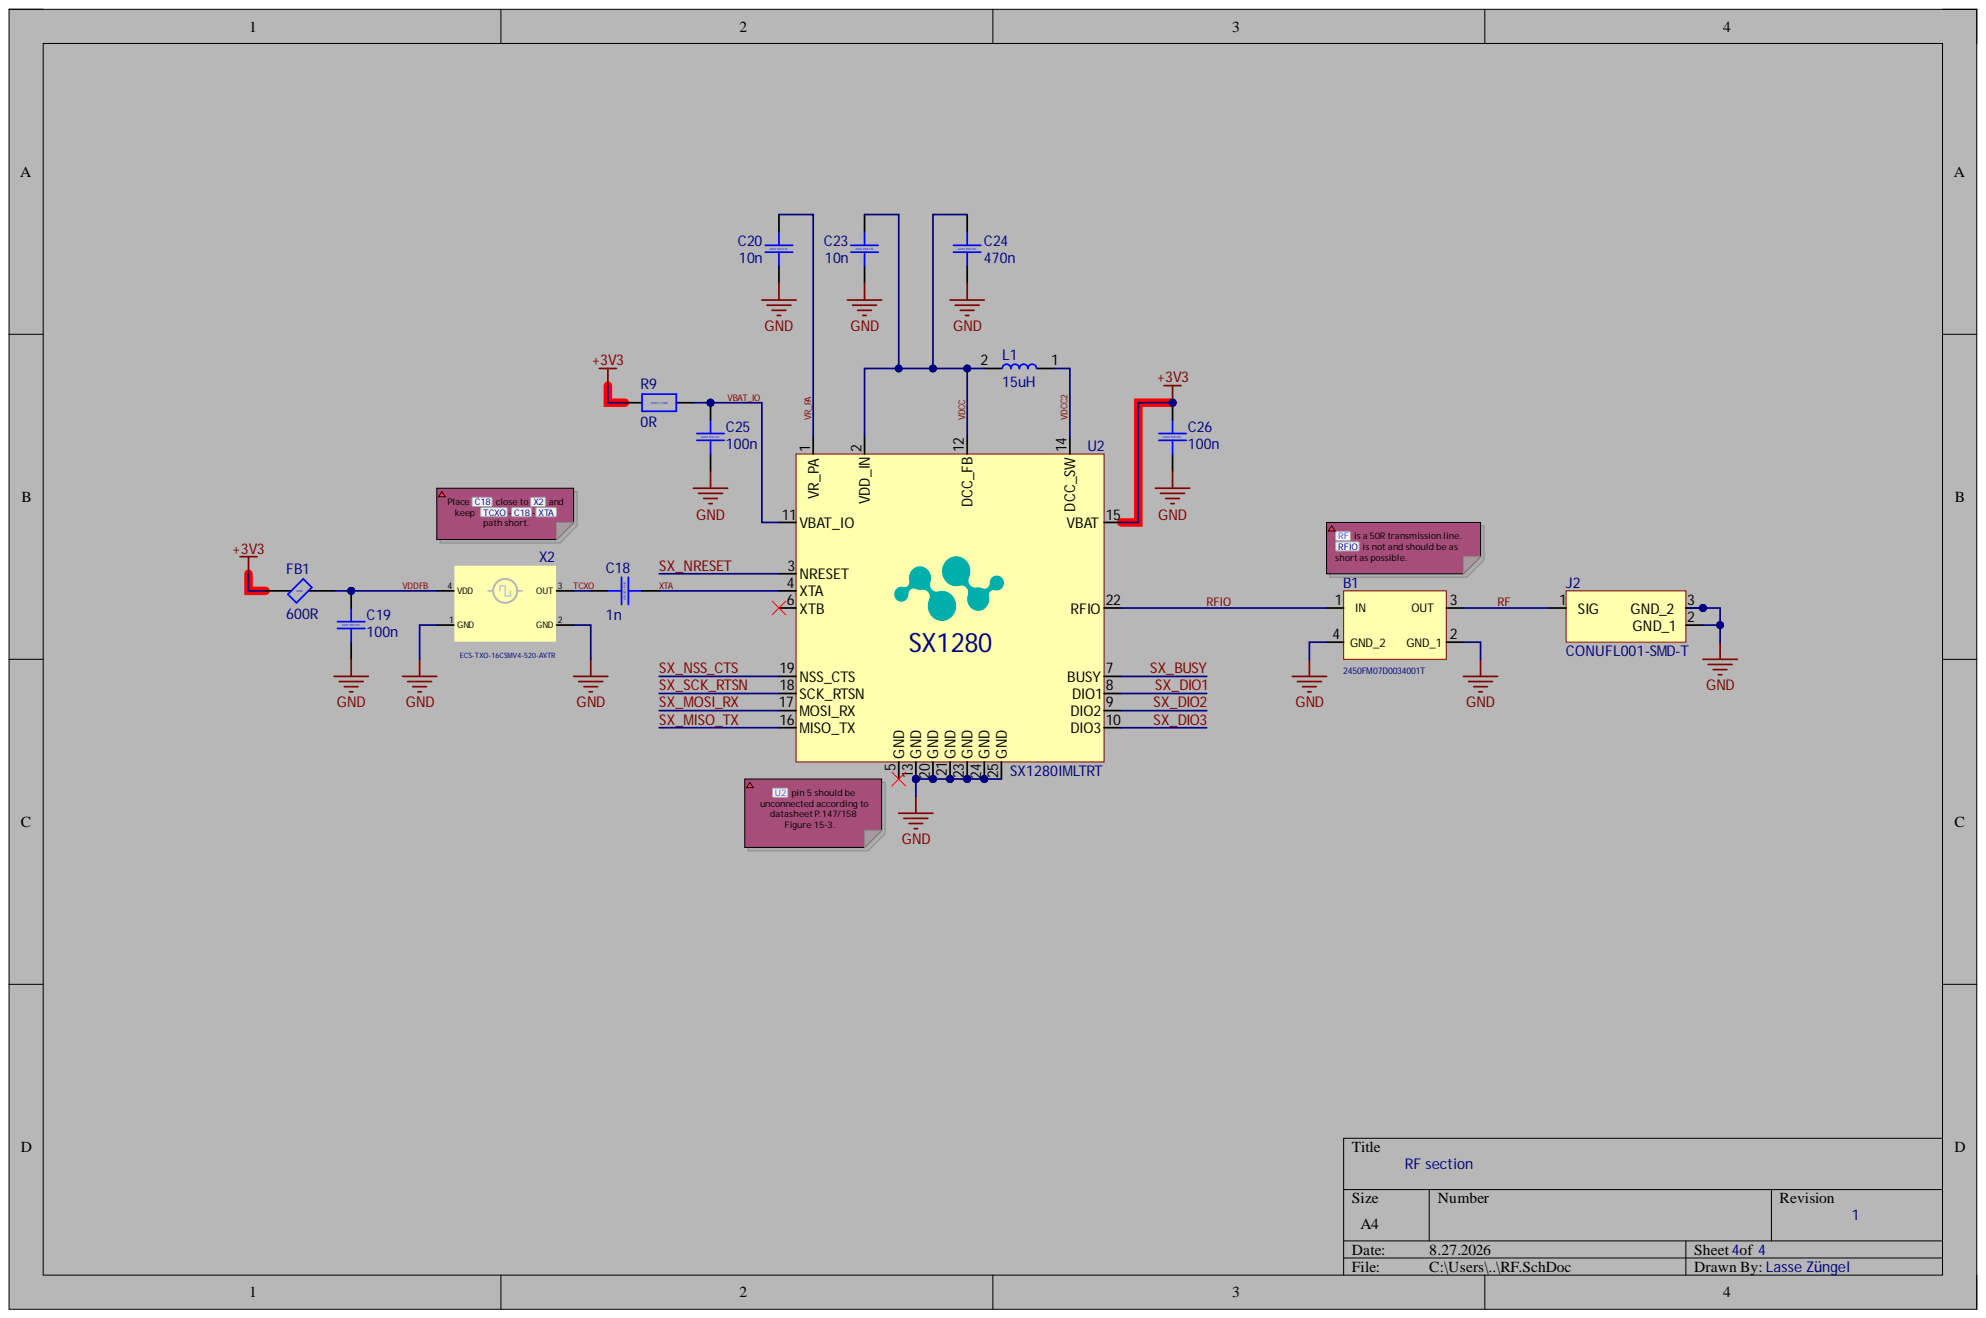
[picture p24: page 4]

Place C18 close to X2 and
keep TCXO - C18 - XTA

RF is a 50R transmission line.
RFIO is not and should be as
short as possible.

ECS-TXO-16CSMV4-520-AY-TR

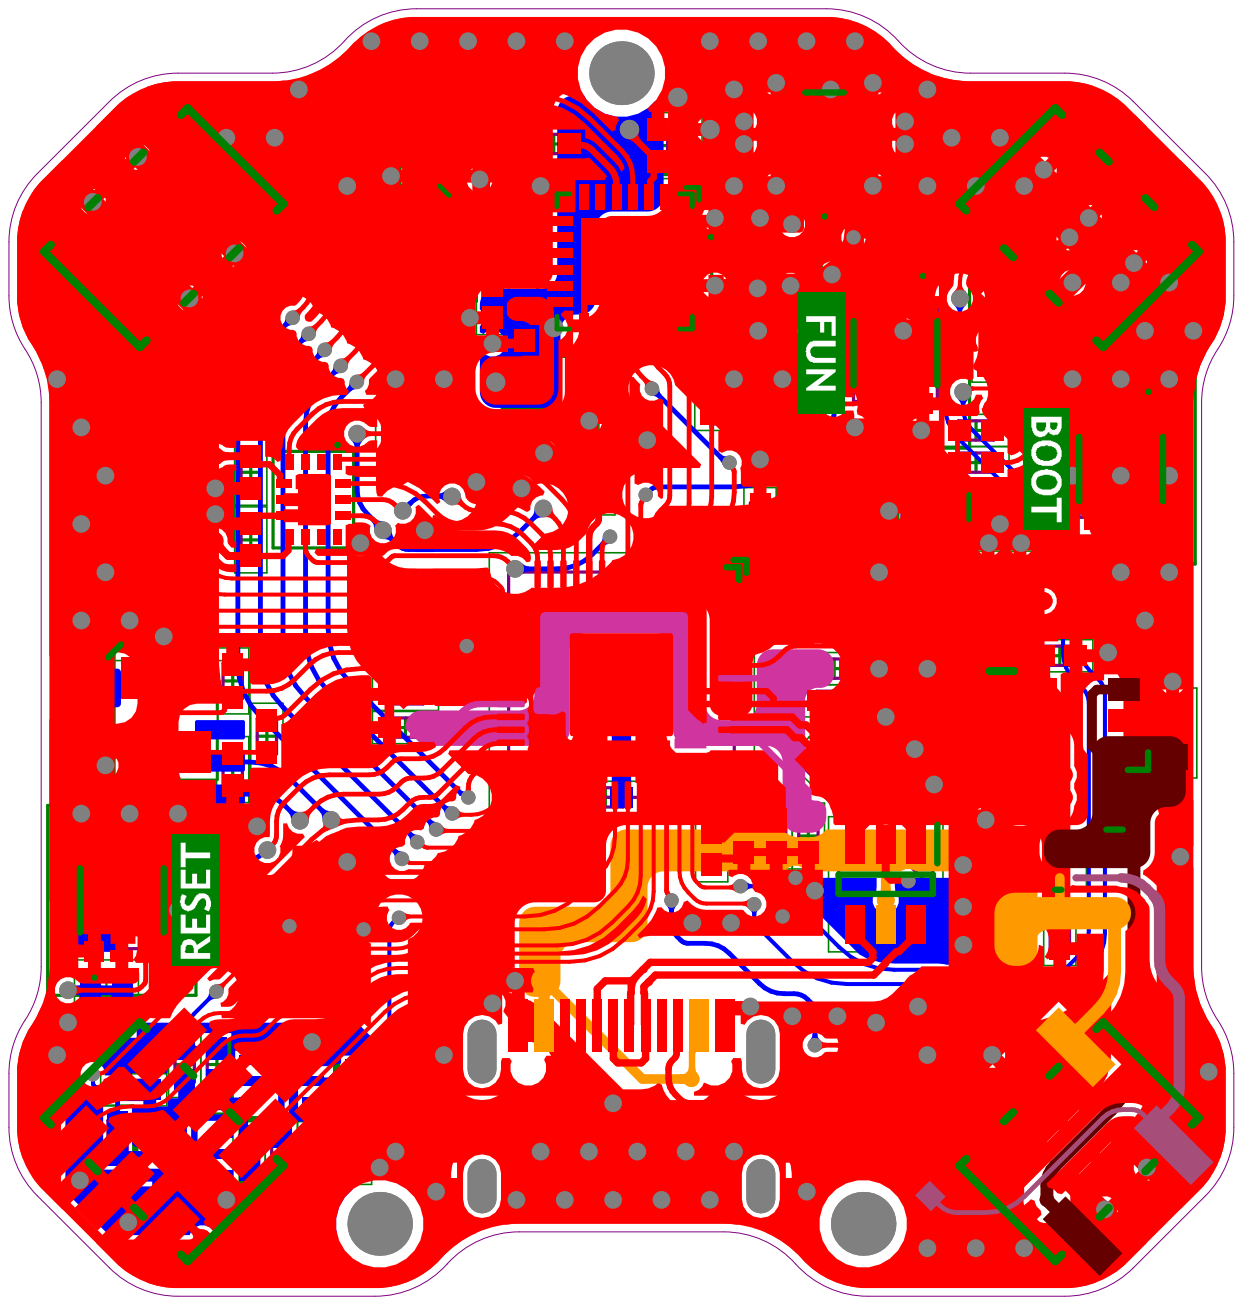
[picture p25: page 5]
