lassezuengel/OpenMicroQuad-S1/(list of files, drawings)

Other design files:
ecad/ESC-FPV/Capacitors.PcbLib
ecad/ESC-FPV/Capacitors.SchLib
ecad/ESC-FPV/Diodes.PcbLib
ecad/ESC-FPV/Diodes.SchLib
ecad/ESC-FPV/Discrete.PcbLib
ecad/ESC-FPV/Discrete.SchLib
ecad/ESC-FPV/ESC-FPV/ESC-FPV.PrjPcb
ecad/ESC-FPV/ESC-FPV/Interfacing.SchDoc
ecad/ESC-FPV/ESC-FPV/Main.SchDoc
ecad/ESC-FPV/ESC-FPV/MotorConnection.SchDoc
ecad/ESC-FPV/ESC-FPV/MotorDriverChannel.SchDoc
ecad/ESC-FPV/ESC-FPV/PCB.PcbDoc
ecad/ESC-FPV/ESC-FPV/Power.SchDoc
ecad/ESC-FPV/Generic.PcbLib
ecad/ESC-FPV/Generic.SchLib
ecad/ESC-FPV/IC.PcbLib
ecad/ESC-FPV/IC.SchLib
ecad/ESC-FPV/Inductors.PcbLib
ecad/ESC-FPV/Inductors.SchLib
ecad/ESC-FPV/Mechanical.PcbLib
ecad/ESC-FPV/Mechanical.SchLib
ecad/ESC-FPV/Misc.PcbLib
ecad/ESC-FPV/Misc.SchLib
ecad/ESC-FPV/Resistors.SchLib
ecad/ESC-FPV/Visual.PcbLib
ecad/ESC-FPV/Visual.SchLib
ecad/RP2040-FPV/Diodes.PcbLib
ecad/RP2040-FPV/Diodes.SchLib
ecad/RP2040-FPV/Discrete.PcbLib
ecad/RP2040-FPV/Discrete.SchLib
ecad/RP2040-FPV/Generic.PcbLib
ecad/RP2040-FPV/Generic.SchLib
ecad/RP2040-FPV/IC.PcbLib
ecad/RP2040-FPV/IC.SchLib
ecad/RP2040-FPV/Inductors.PcbLib
ecad/RP2040-FPV/Inductors.SchLib
ecad/RP2040-FPV/Mechanical.PcbLib
ecad/RP2040-FPV/Mechanical.SchLib
ecad/RP2040-FPV/Misc.PcbLib
ecad/RP2040-FPV/Misc.SchLib
ecad/RP2040-FPV/RP2040-FPV/Interfacing.SchDoc
ecad/RP2040-FPV/RP2040-FPV/MCU.SchDoc
ecad/RP2040-FPV/RP2040-FPV/PCB.PcbDoc
ecad/RP2040-FPV/RP2040-FPV/Power.SchDoc
ecad/RP2040-FPV/RP2040-FPV/RF.SchDoc
ecad/RP2040-FPV/RP2040-FPV/RP2040-FPV.PrjPcb
ecad/RP2040-FPV/Visual.PcbLib
ecad/RP2040-FPV/Visual.SchLib
