lassezuengel/OpenMicroQuad-S1/(commit log)

2026-10-10 Add design files for ESC and FCU
    [Capacitors.PcbLib, Capacitors.SchLib, Diodes.PcbLib, Diodes.SchLib, Discrete.PcbLib, Discrete.SchLib, ESC-FPV.PrjPcb, Generic.PcbLib]
2026-10-10 Add PCB renders
    [Drone 1S.step]
2026-10-10 Add temperature measurements and important images
2026-10-12 Update ESC ecad exports and packaging
    [Capacitors.PcbLib, Capacitors.SchLib, Diodes.PcbLib, Diodes.SchLib, Discrete.PcbLib, Discrete.SchLib, ESC-FPV.PrjPcb, Generic.PcbLib]
