lassezuengel/OpenMicroQuad-S1/assets/setup-stationary.png

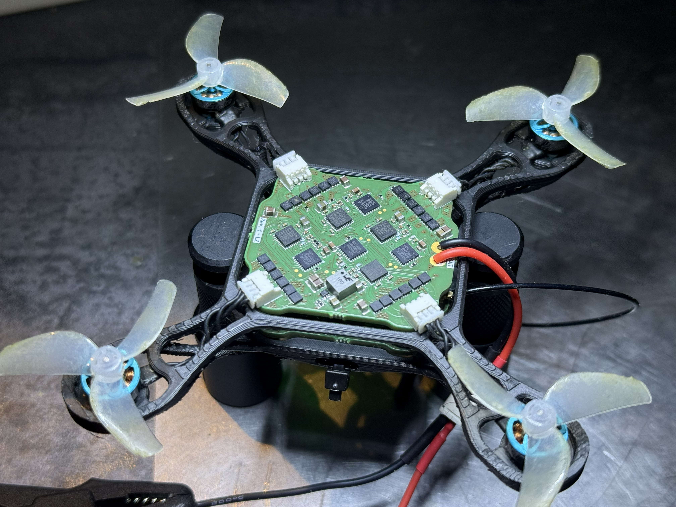
[picture p7: assets/setup-stationary.png]
assets/setup-stationary.png
